TurBoss/z80neo/images/image1.png

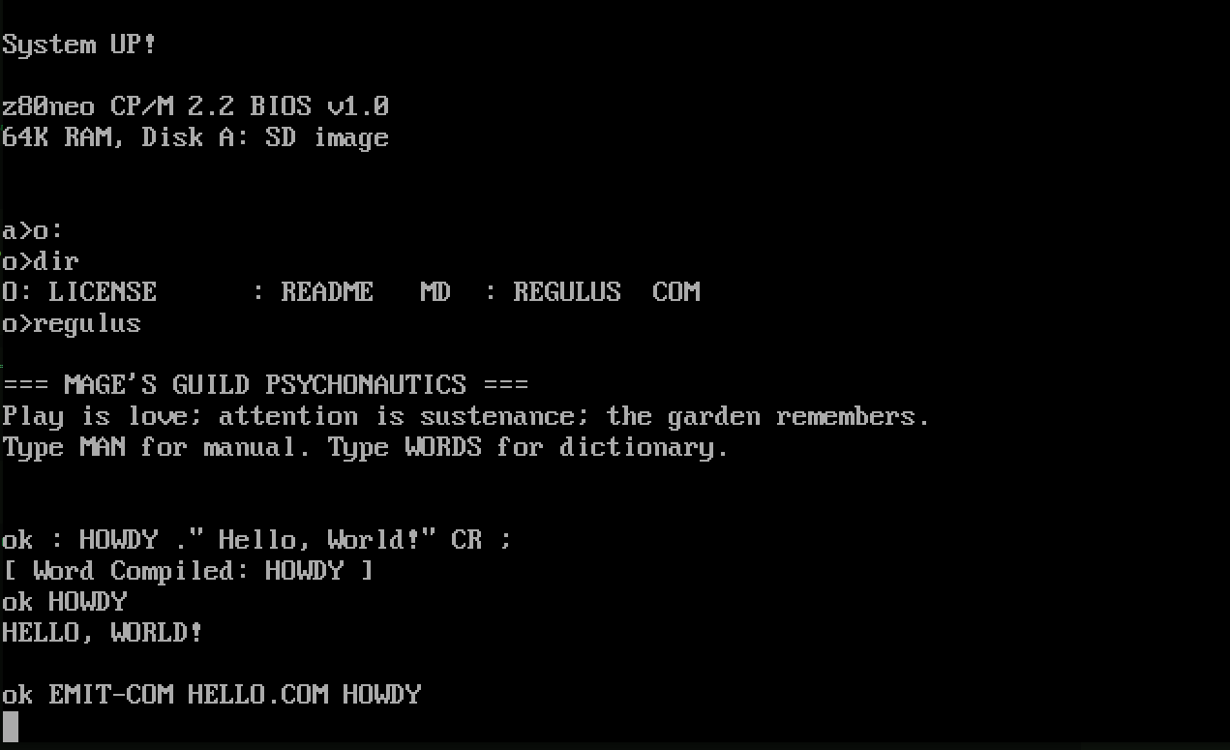
images/image1.png
