TurBoss/z80neo/images/image2.png

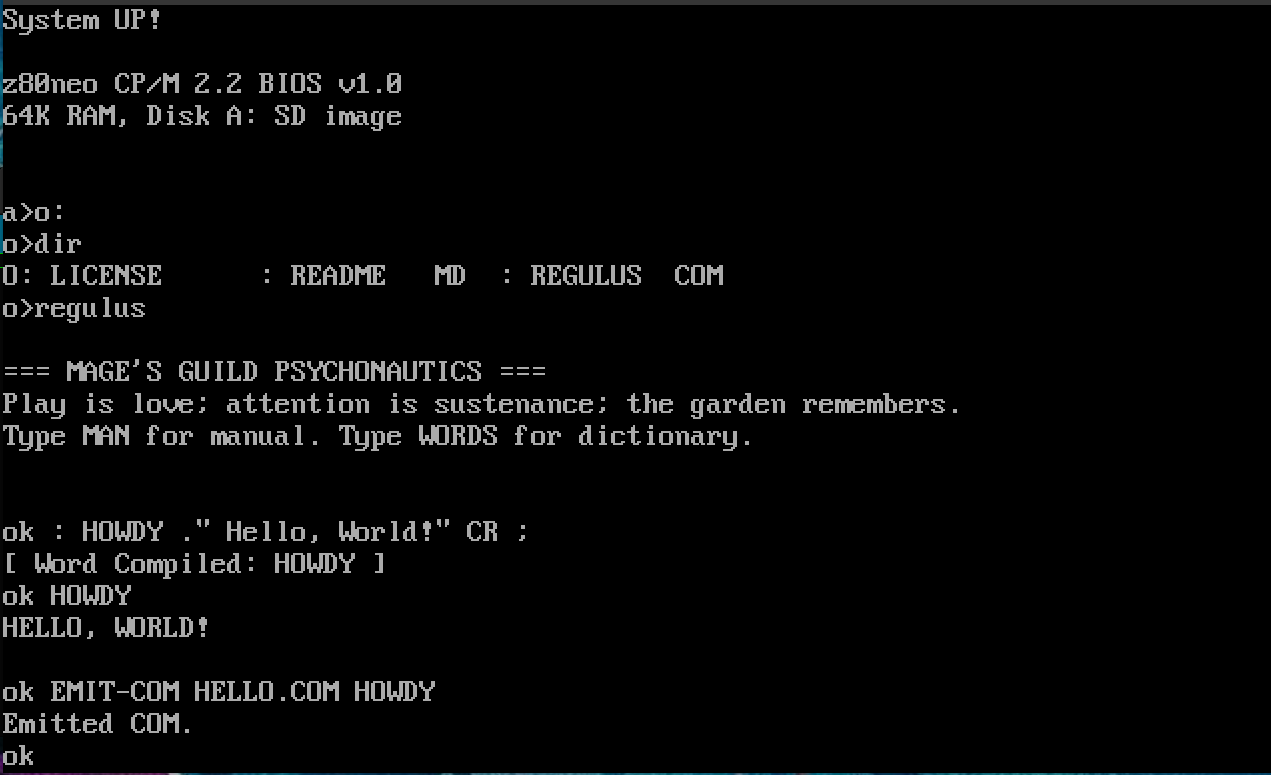
images/image2.png
