TurBoss/z80neo/images/image3.png

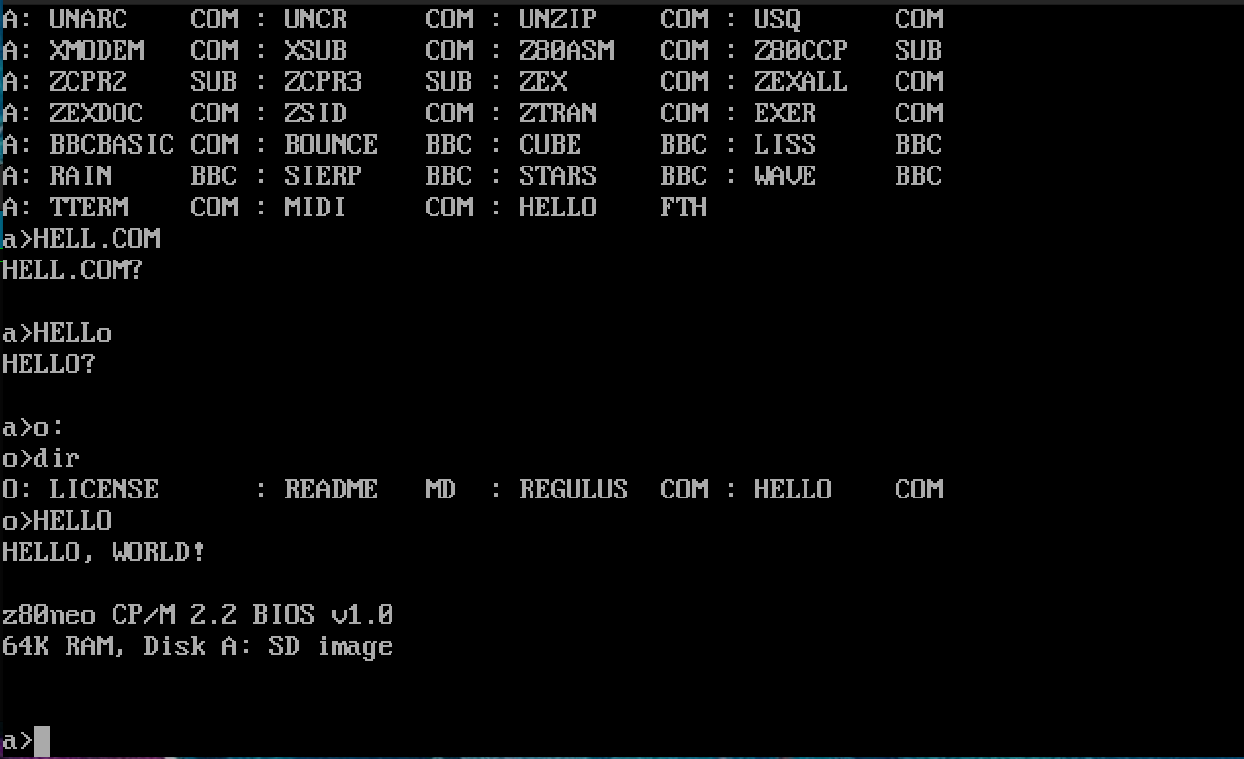
images/image3.png
