TurBoss/z80neo/images/image.png

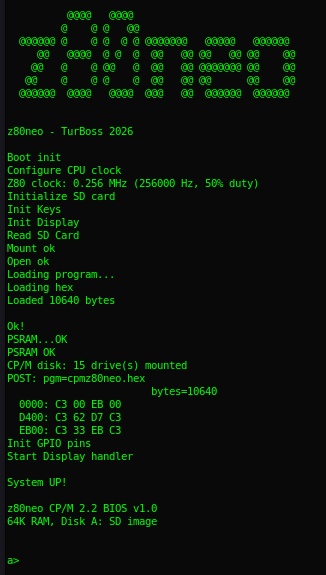
images/image.png
