TurBoss/z80neo/images/regulus.png

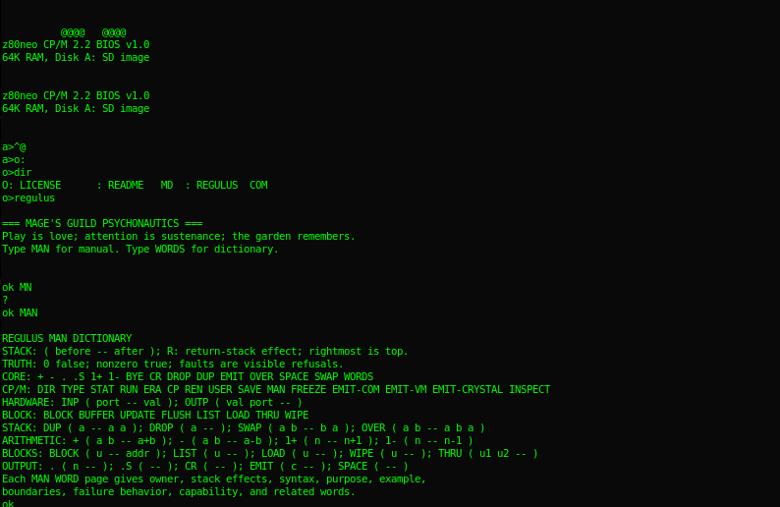
images/regulus.png
