TurBoss/z80neo/images/rn_image_picker_lib_temp_3ced0ee5-24de-4b00-89b0-9636c9db9d4b.jpg

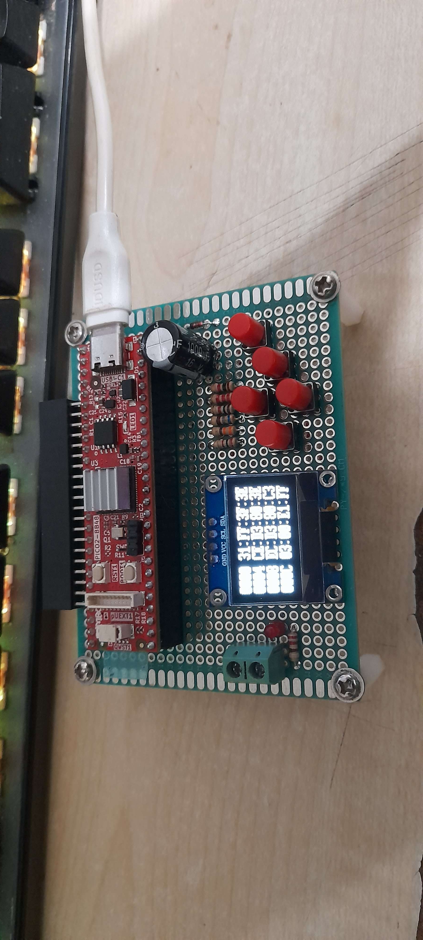
images/rn_image_picker_lib_temp_3ced0ee5-24de-4b00-89b0-9636c9db9d4b.jpg
