TurBoss/z80neo/images/rn_image_picker_lib_temp_8c398ad6-d32f-4aa8-9d74-71f9833cbe23.jpg

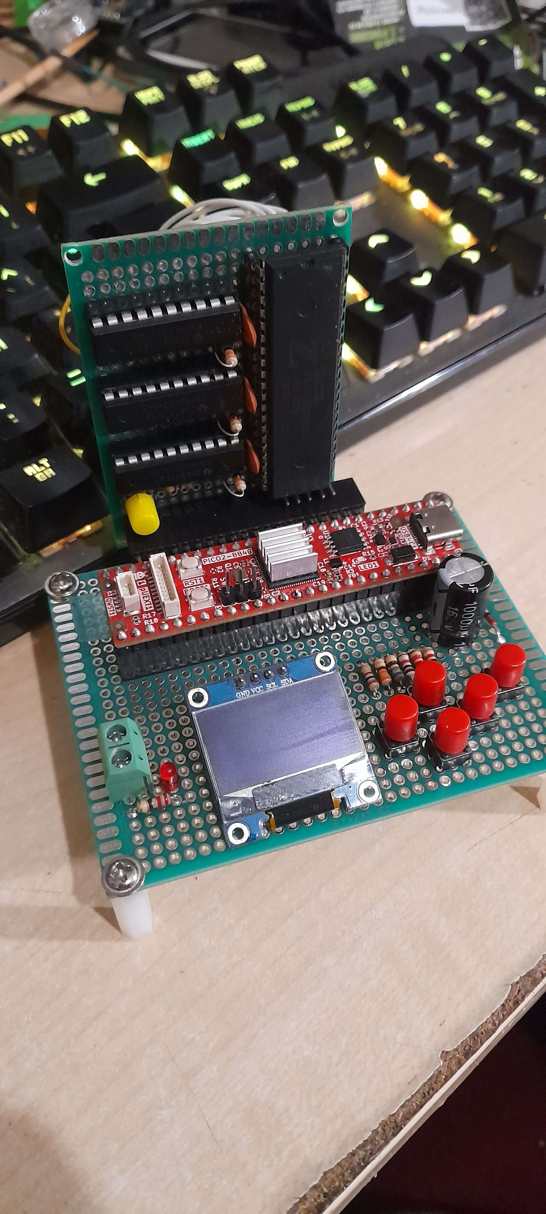
images/rn_image_picker_lib_temp_8c398ad6-d32f-4aa8-9d74-71f9833cbe23.jpg
