TurBoss/z80neo/images/rn_image_picker_lib_temp_10f30920-b8a1-4bfb-8cc0-7e3f8f440144.jpg

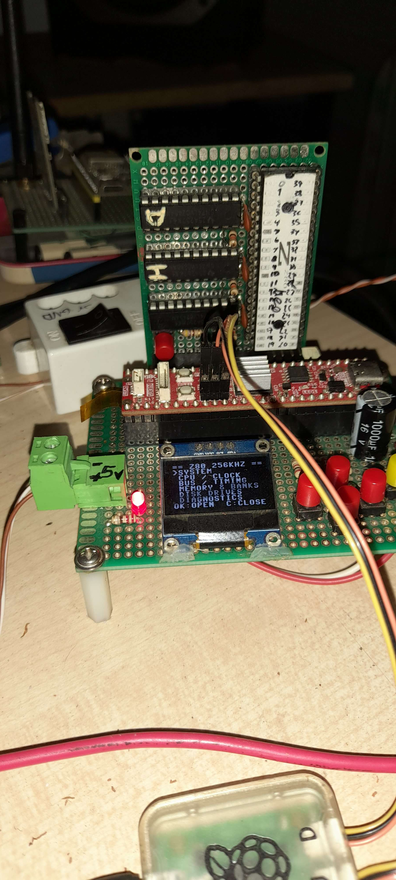
images/rn_image_picker_lib_temp_10f30920-b8a1-4bfb-8cc0-7e3f8f440144.jpg
