TurBoss/z80neo/images/rn_image_picker_lib_temp_57b4c988-b5c6-46c3-9d2c-d105b50022b2.jpg

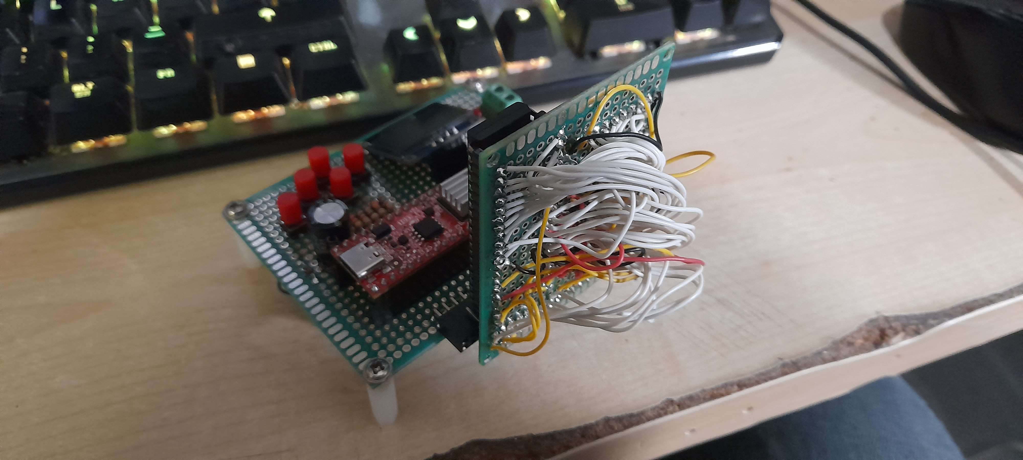
images/rn_image_picker_lib_temp_57b4c988-b5c6-46c3-9d2c-d105b50022b2.jpg
