TurBoss/z80neo/images/screen.png

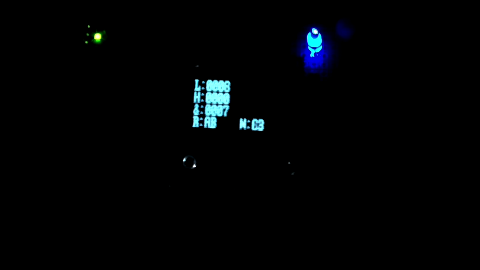
images/screen.png
