TurBoss/z80neo/images/z80neo_THT.png

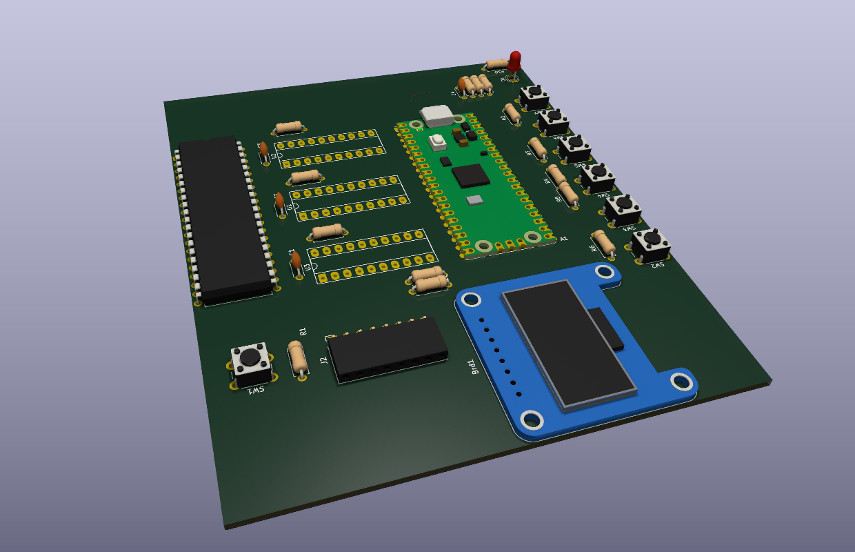
images/z80neo_THT.png
