TurBoss/z80neo/images/z80neo_v2.jpg

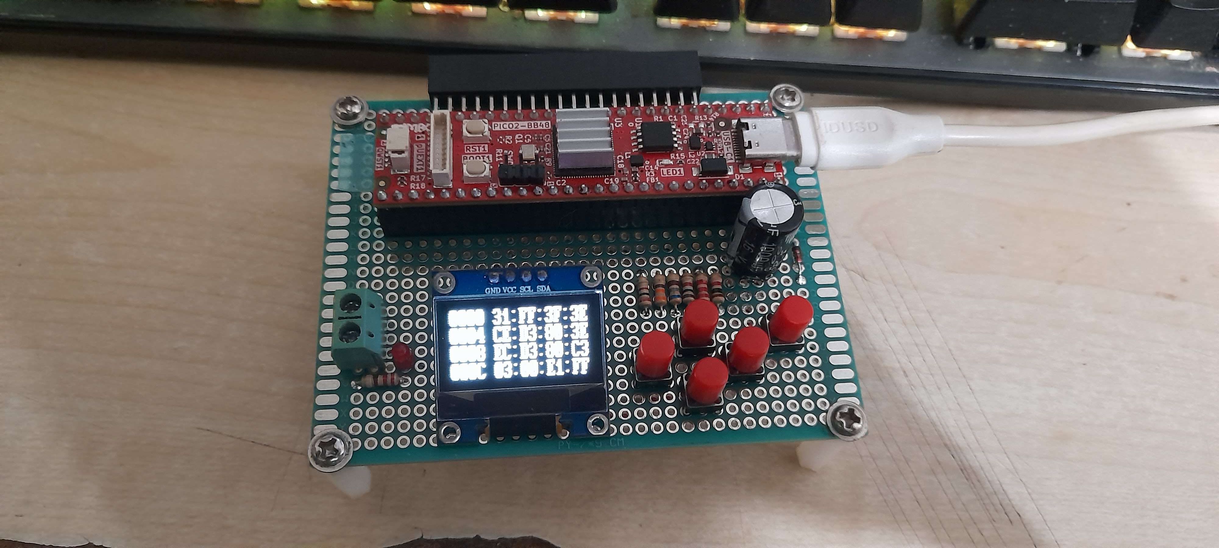
images/z80neo_v2.jpg
