TurBoss/z80neo/doc/RP2350-PICO2-BB48-user-manual-1.pdf

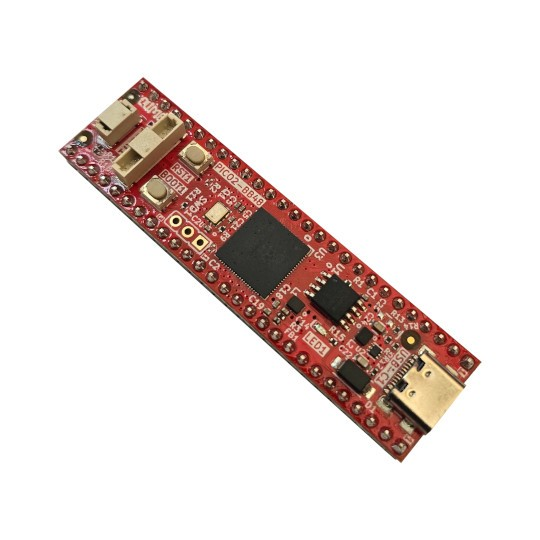
[picture p20: figure]

# RP2350-PICO2-BB48

# User Manual

Rev.1.0 September 2025 | olimex.com

Table of Contents

### Introduction to RP2350-PICO2-BB48

RP2350-PICO2- (https://www.olimex.com/Products/RaspberryPi/PICO/RP2350-PICO2-BB48/open-source-hardware) BB48 (https://www.olimex.com/Products/RaspberryPi/PICO/RP2350-PICO2-BB48/open-source-hardware) is re-design of the popular Raspberry PI PICO2 board with these improvements:

- all 48 RP2350 GPIOs are available to the user
- USB-C power supply connector which allow more current to be used by the board
- DCDC power supply voltage regulator 3.3V 2A (3A peak)
- 16MB Flash versions
- 8MB PSRAM for BB48R version
- micro SD card connector for XXL version
- RESET button is add
- Four layer board for better noise immunity and USB differential pair routing
- UEXT connector (pUEXT 1.0 mm step connector)
- Qwiic/Stemma connector
- Distance between signal rows 0.6” (15.24mm)
- Dimensions 69x18 mm

# Note:

Both RP2350-PICO2- (https://www.olimex.com/Products/RaspberryPi/PICO/RP2350-PICO2-BB48/open-source-hardware) BB48 (https://www.olimex.com/Products/RaspberryPi/PICO/RP2350-PICO2-BB48/open-source-hardware) and RP2350-PICO2- (https://www.olimex.com/Products/RaspberryPi/PICO/RP2350-PICO2-BB48/open-source-hardware) BB48R (https://www.olimex.com/Products/RaspberryPi/PICO/RP2350-PICO2-BB48/open-source-hardware) share same PCB with same silkscreen where PP2350-PICO2-BB48 is written! The only difference is that in BB48 version PSRAM and micro SD card (both on bottom side of the PCB) are not populated.

### Order codes for RP2350-PICO2-BB48 and accessories:

RP2350-PICO2- (https://www.olimex.com/Products/RaspberryPi/PICO/RP2350-PICO2-BB48/open-source-hardware) BB48 (https://www.olimex.com/Products/RaspberryPi/PICO/RP2350-PICO2-BB48/open-source-hardware) | industrial grade RP2350-PICO2 board with 48 GPIOs exposed
RP2350-PICO2- (https://www.olimex.com/Products/RaspberryPi/PICO/RP2350-PICO2-BB48R/open-source-hardware) BB48R (https://www.olimex.com/Products/RaspberryPi/PICO/RP2350-PICO2-BB48R/open-source-hardware) | includes everything in BB48 plus 8MB PSRAM and microSD card

USB-CABLE-AM-USB3-C (https://www.olimex.com/Products/Components/Cables/USB-CABLE-AM-USB3-C/) high quality USB-C cable for power and programming

p (https://www.olimex.com/Products/Modules/Adapters/pUEXT-CABLE-10-10-200MM/) UEXT (https://www.olimex.com/Products/Modules/Adapters/pUEXT-CABLE-10-10-200MM/) pack of (https://www.olimex.com/Products/Modules/Adapters/pUEXT-CABLE-10-10-200MM/) cable (https://www.olimex.com/Products/Modules/Adapters/pUEXT-CABLE-10-10-200MM/) s (https://www.olimex.com/Products/Modules/Adapters/pUEXT-CABLE-10-10-200MM/) | pack of 3 pcs 200 mm pUEXT cables
UEXT-MPQ (https://www.olimex.com/Products/Modules/Adapters/UEXT-MPQ/open-source-hardware) | converter board from pUEXT to UEXT

### HARDWARE

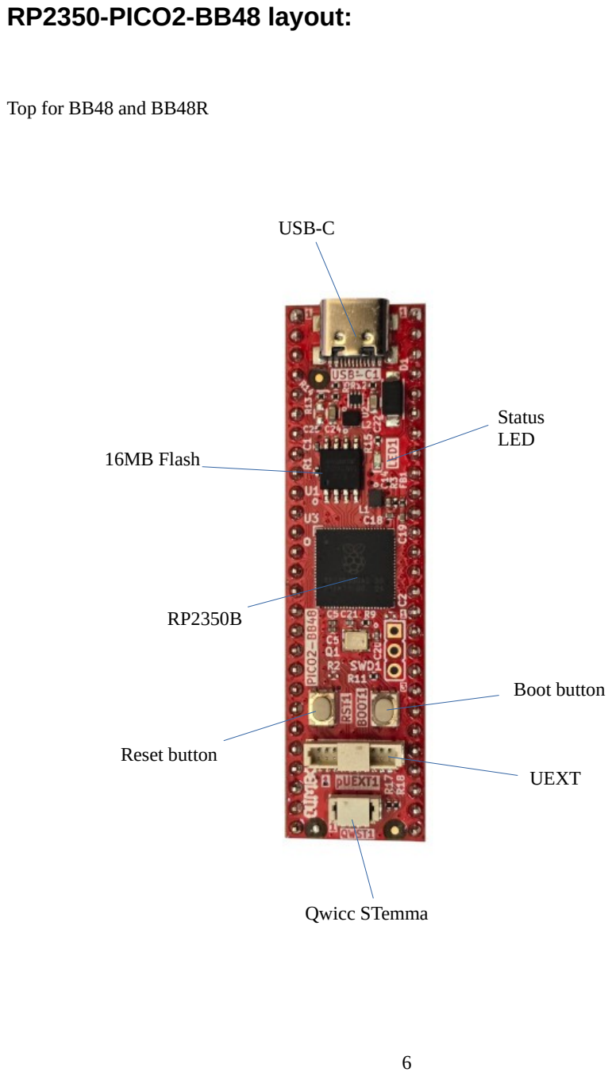
[picture p21: page 6]

RP2350-PICO2-BB48 layout:

Top for BB48 and BB48R

USB-C

Status
LED

Boot button

UEXT

Qwicc STemma

Reset button

RP2350B

16MB Flash

Bottom for BB48

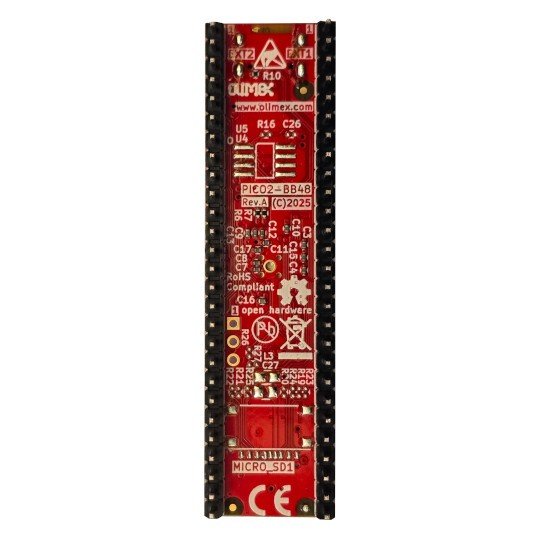
[picture p22: figure]
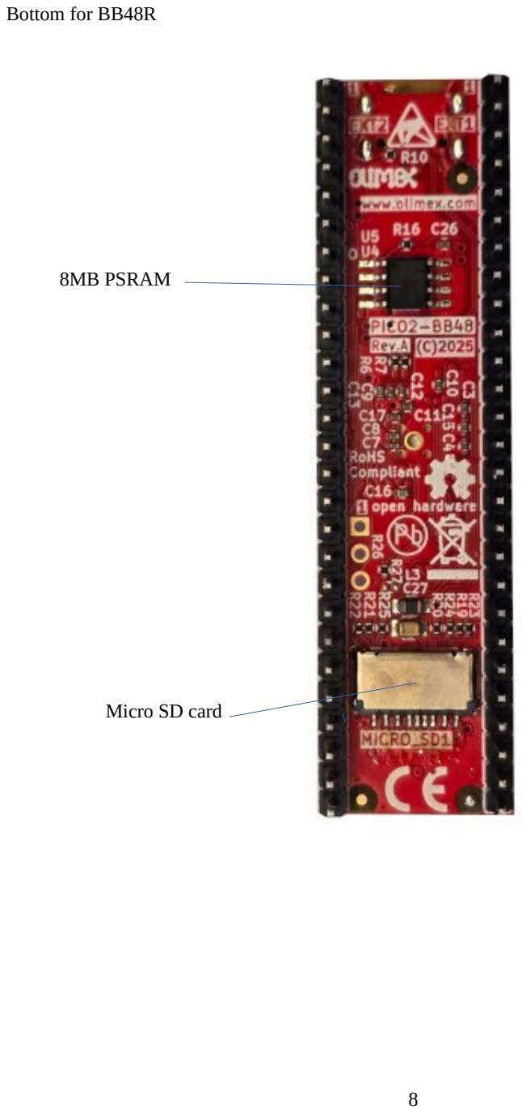
[picture p23: page 8]

Bottom for BB48R

8MB PSRAM

Micro SD card

RP2350-PICO2-BB48 GPIOs:

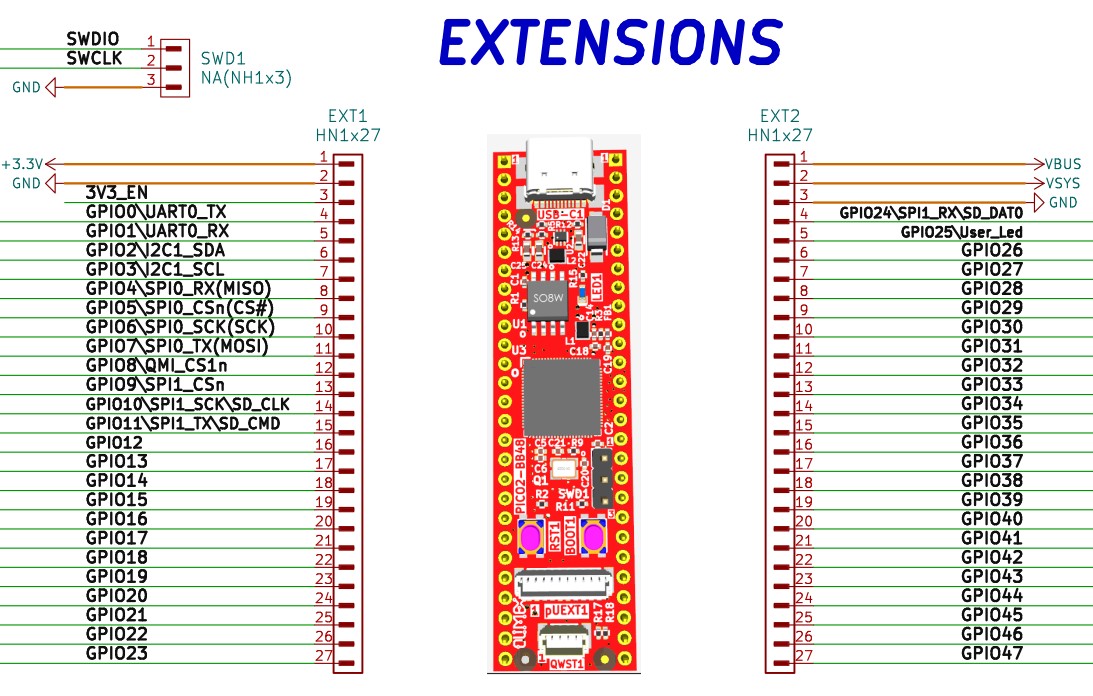
[picture p24: figure]

## POWER SUPPLY:

VBUS | +5V from, USB-C output
VDD_SYS | +5V may be output or input
| if you want to use as input i.e. to feed power from external 5V to this line make sure board is not connected to USB!
| when you use as output i.e. you feed external electronics from it up to 1A @ 5V
+3.3V | output which can source up to 2A @ 3.3V
3V3_EN | input, when pulled to GND stops the 3.3V DCDC convertor

RP2350-PICO2-BB48 schematics:

RP2350-PICO2- (https://www.olimex.com/Products/RaspberryPi/PICO/RP2350-PICO2-BB48/open-source-hardware) BB48 (https://www.olimex.com/Products/RaspberryPi/PICO/RP2350-PICO2-BB48/open-source-hardware) latest schematic is on GitHub. (https://github.com/OLIMEX/RP2350-PICO2-BB48/tree/main/HARDWARE)

UEXT connector:

UEXT connector stands for Universal EXTension connector and contain +3.3V, GND, I2C, SPI, UART signals.

UEXT connector can be in different shapes.

The original UEXT connector is 0.1” 2.54mm step boxed plastic connector. All signals are with 3.3V levels.

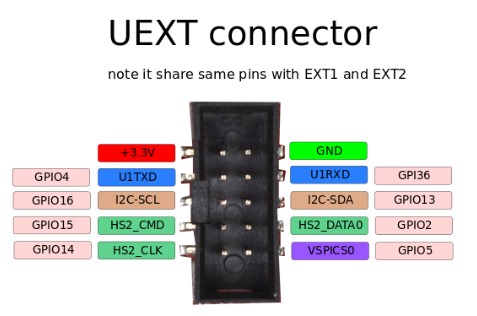
[picture p25: figure]

As the boards become smaller and smaller some smaller packages were introduced too beside the original UEXT connector

- mUEXT is 1.27 mm step boxed header connector which is with same layout as UEXT
- pUEXT is 1.0 mm single row connector (this is the connector used in RP2040-PICO30)

Olimex has developed number of MODULES (https://www.olimex.com/Products/Modules/) with this connector. There are temperature, humidity, pressure, magnetic field, light sensors. Modules with LCDs, LED matrix, Relays, Bluetooth, Zigbee, WiFi, GSM, GPS, RFID, RTC, EKG, sensors and etc.

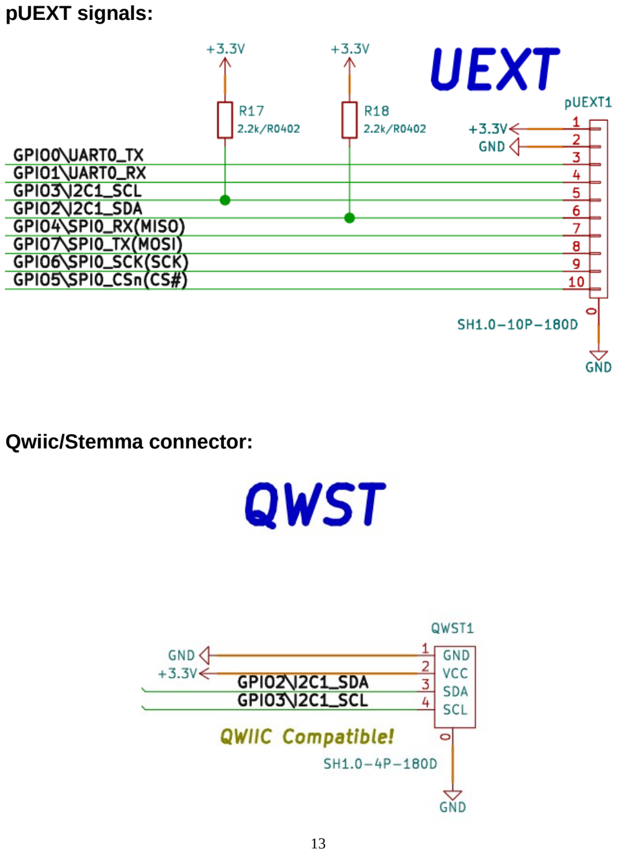
[picture p26: page 13]

pUEXT signals:

Qwiic/Stemma connector:

Micro SD card connection:

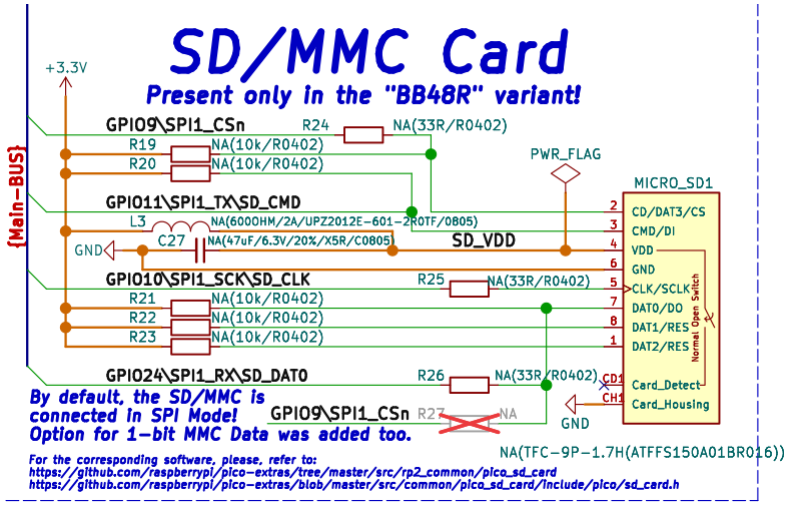
[picture p27: figure]

PSRAM connection:

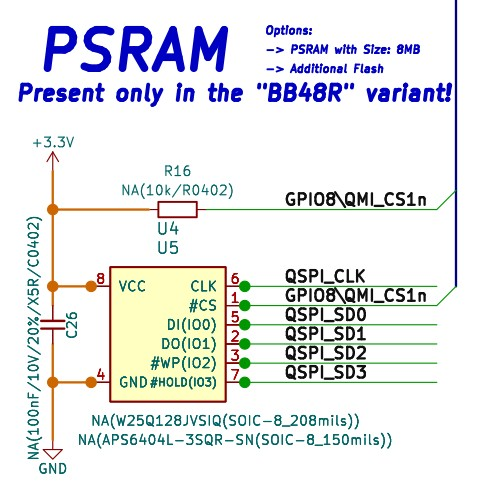
[picture p28: figure]

LED connection:

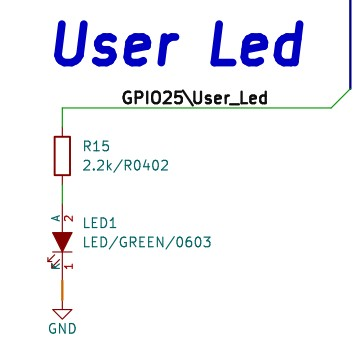
[picture p29: figure]

### SOFTWARE:

RP2350-PICO2-BB48 uses same software as PICO2

- Raspberry PI C-SDK
- MicroPython SDK (note that to the current date RP2350B chip support is not implemented in MicroPython and the access of the GPIO30-47 in MicroPython is not implemented.
- CircuitPython from Adafruit – all 48 GPIOs are implemented.

### Revision History

Revision 1.0 September 2025
