TurBoss/z80neo/hardware/z80neo_03.pdf

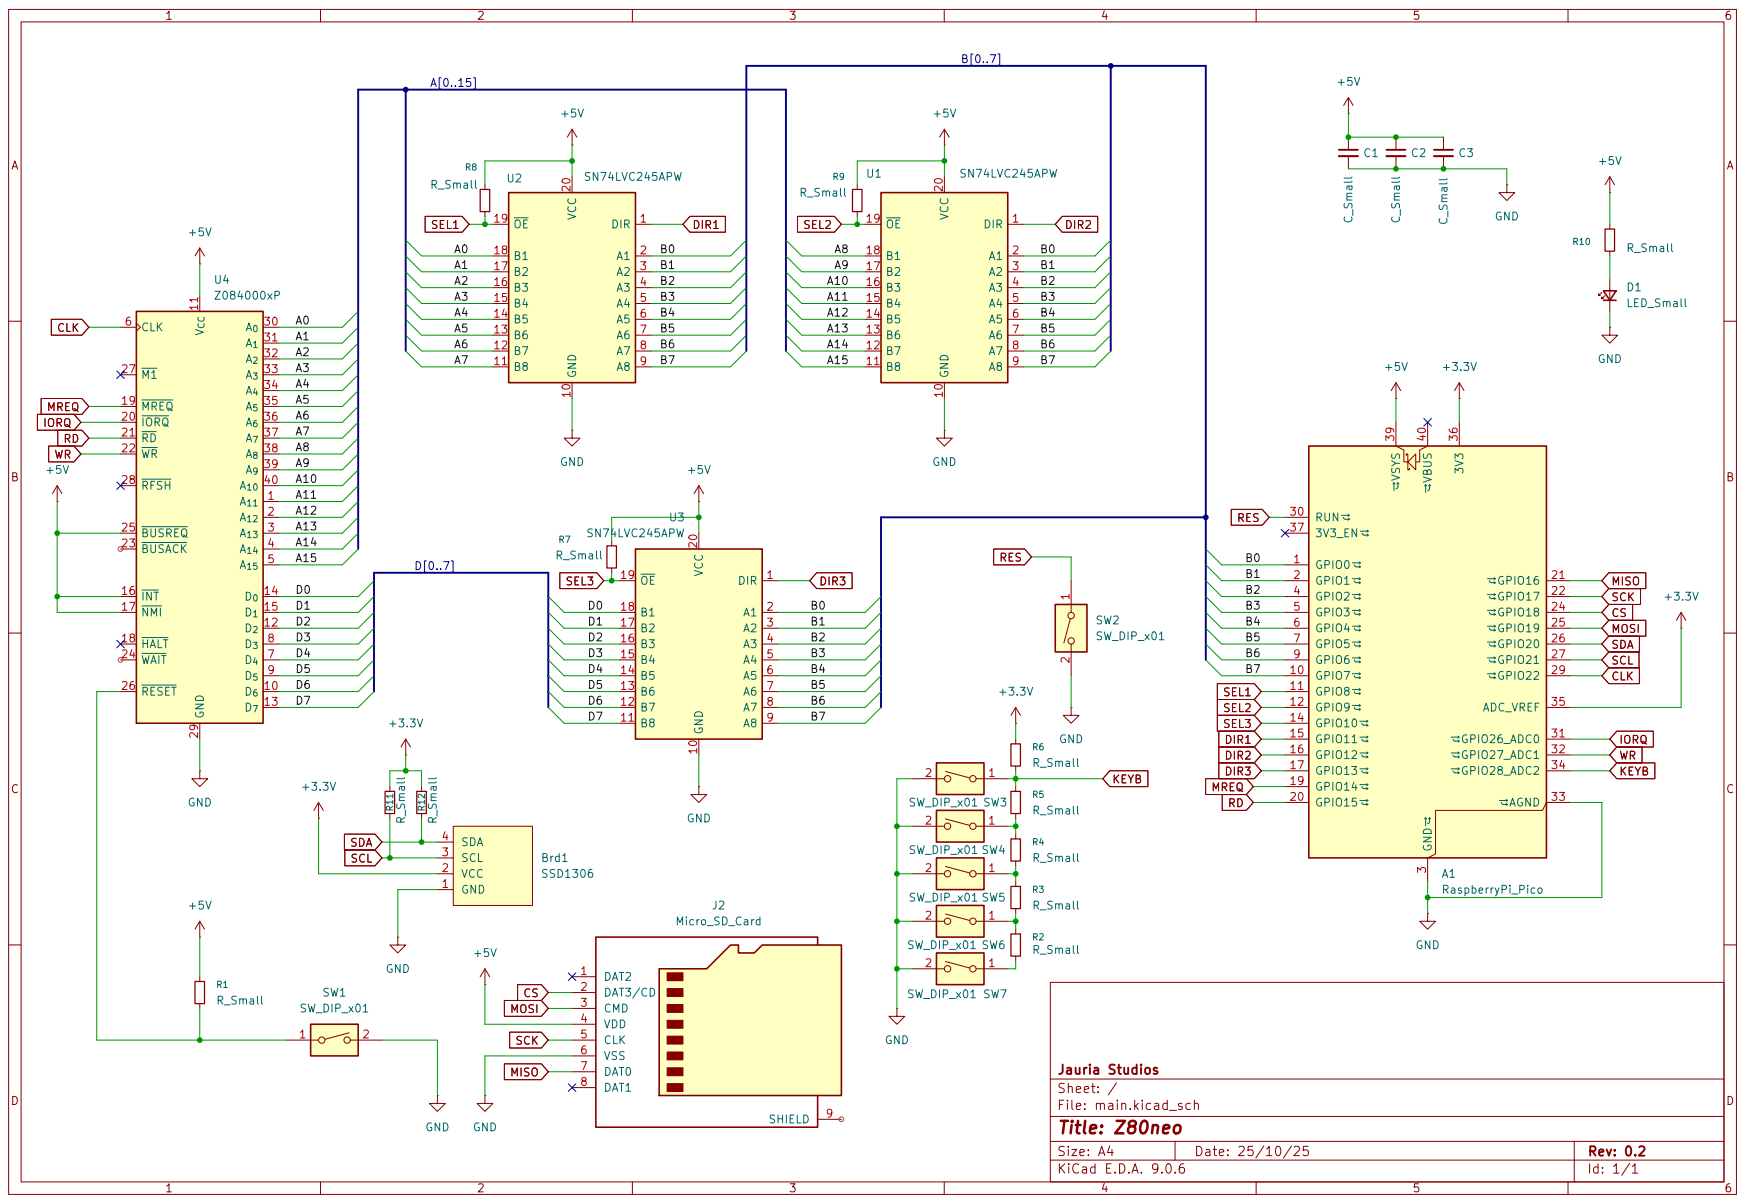
[picture p31: page 1]
