TurBoss/z80neo/hardware/z80neo_02.pdf

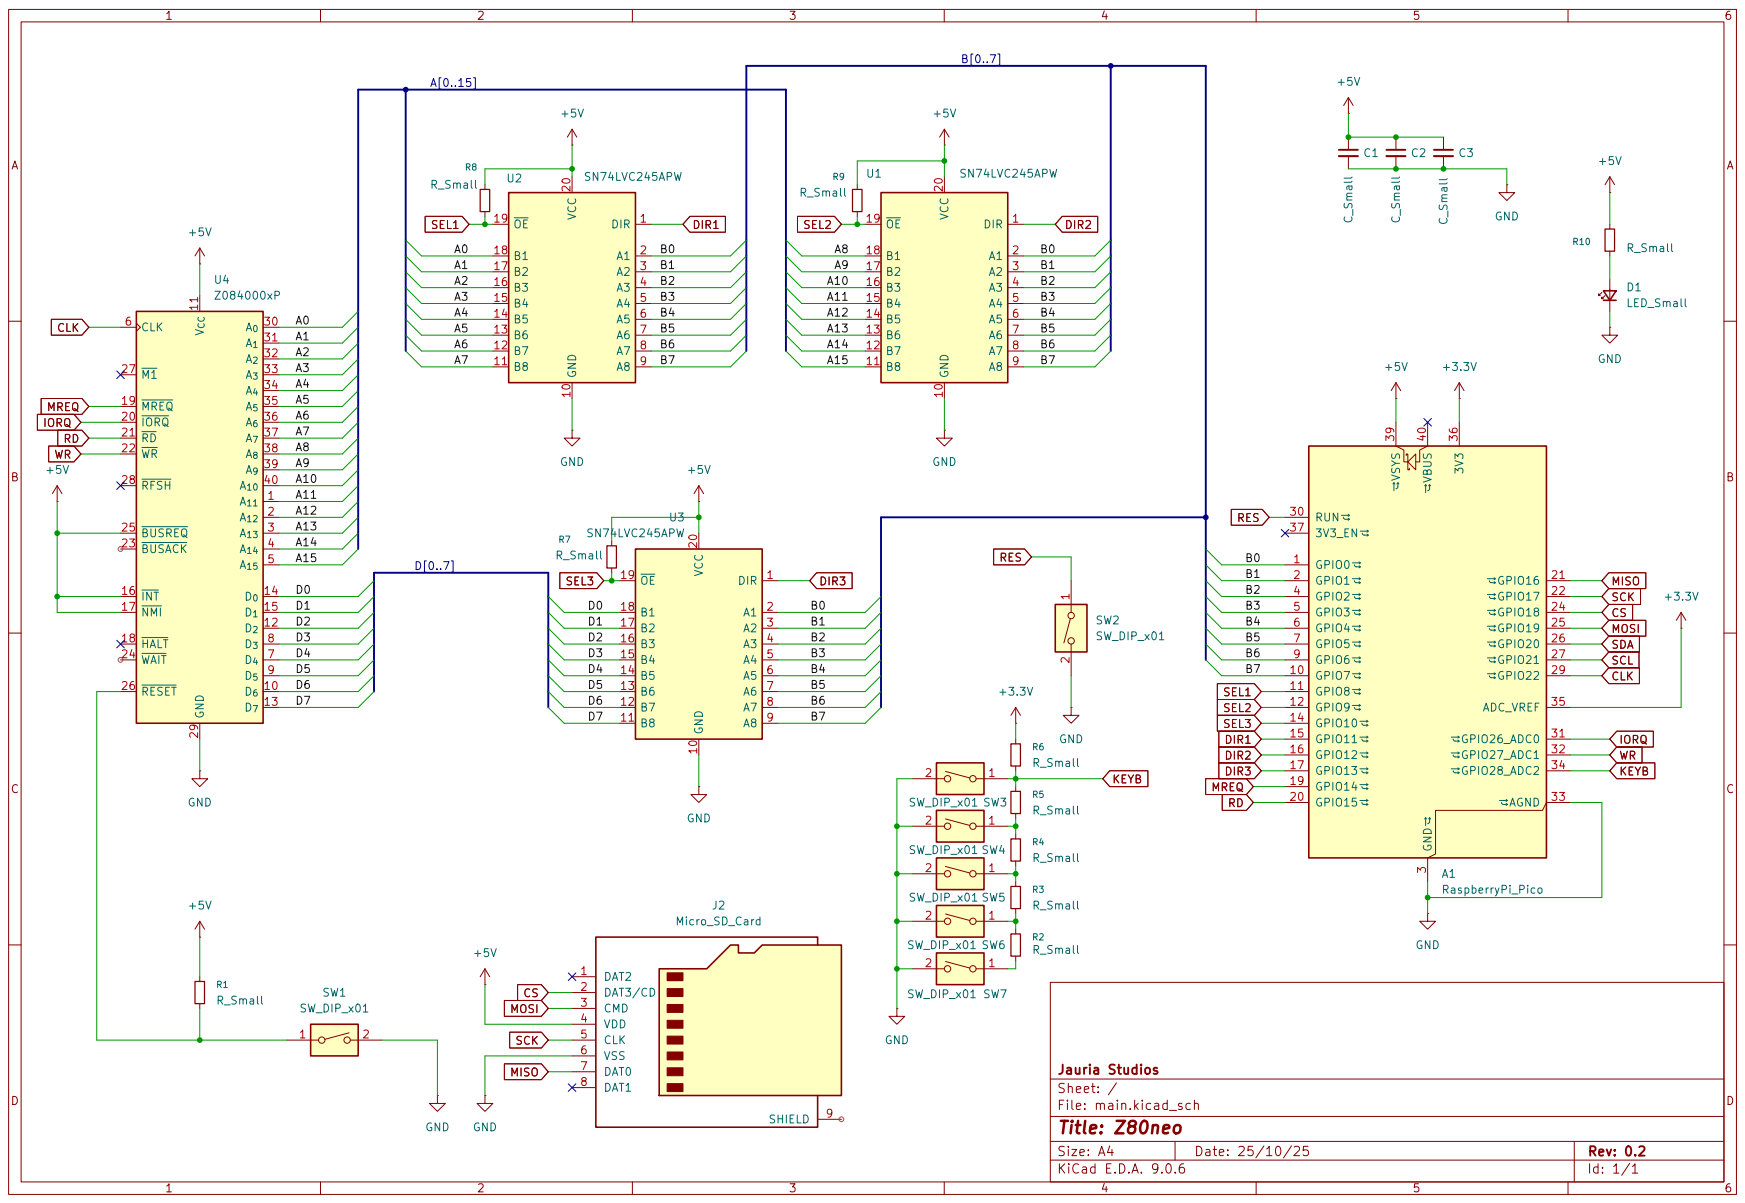
[picture p32: page 1]
