TurBoss/z80neo/hardware/z80neo_01.pdf

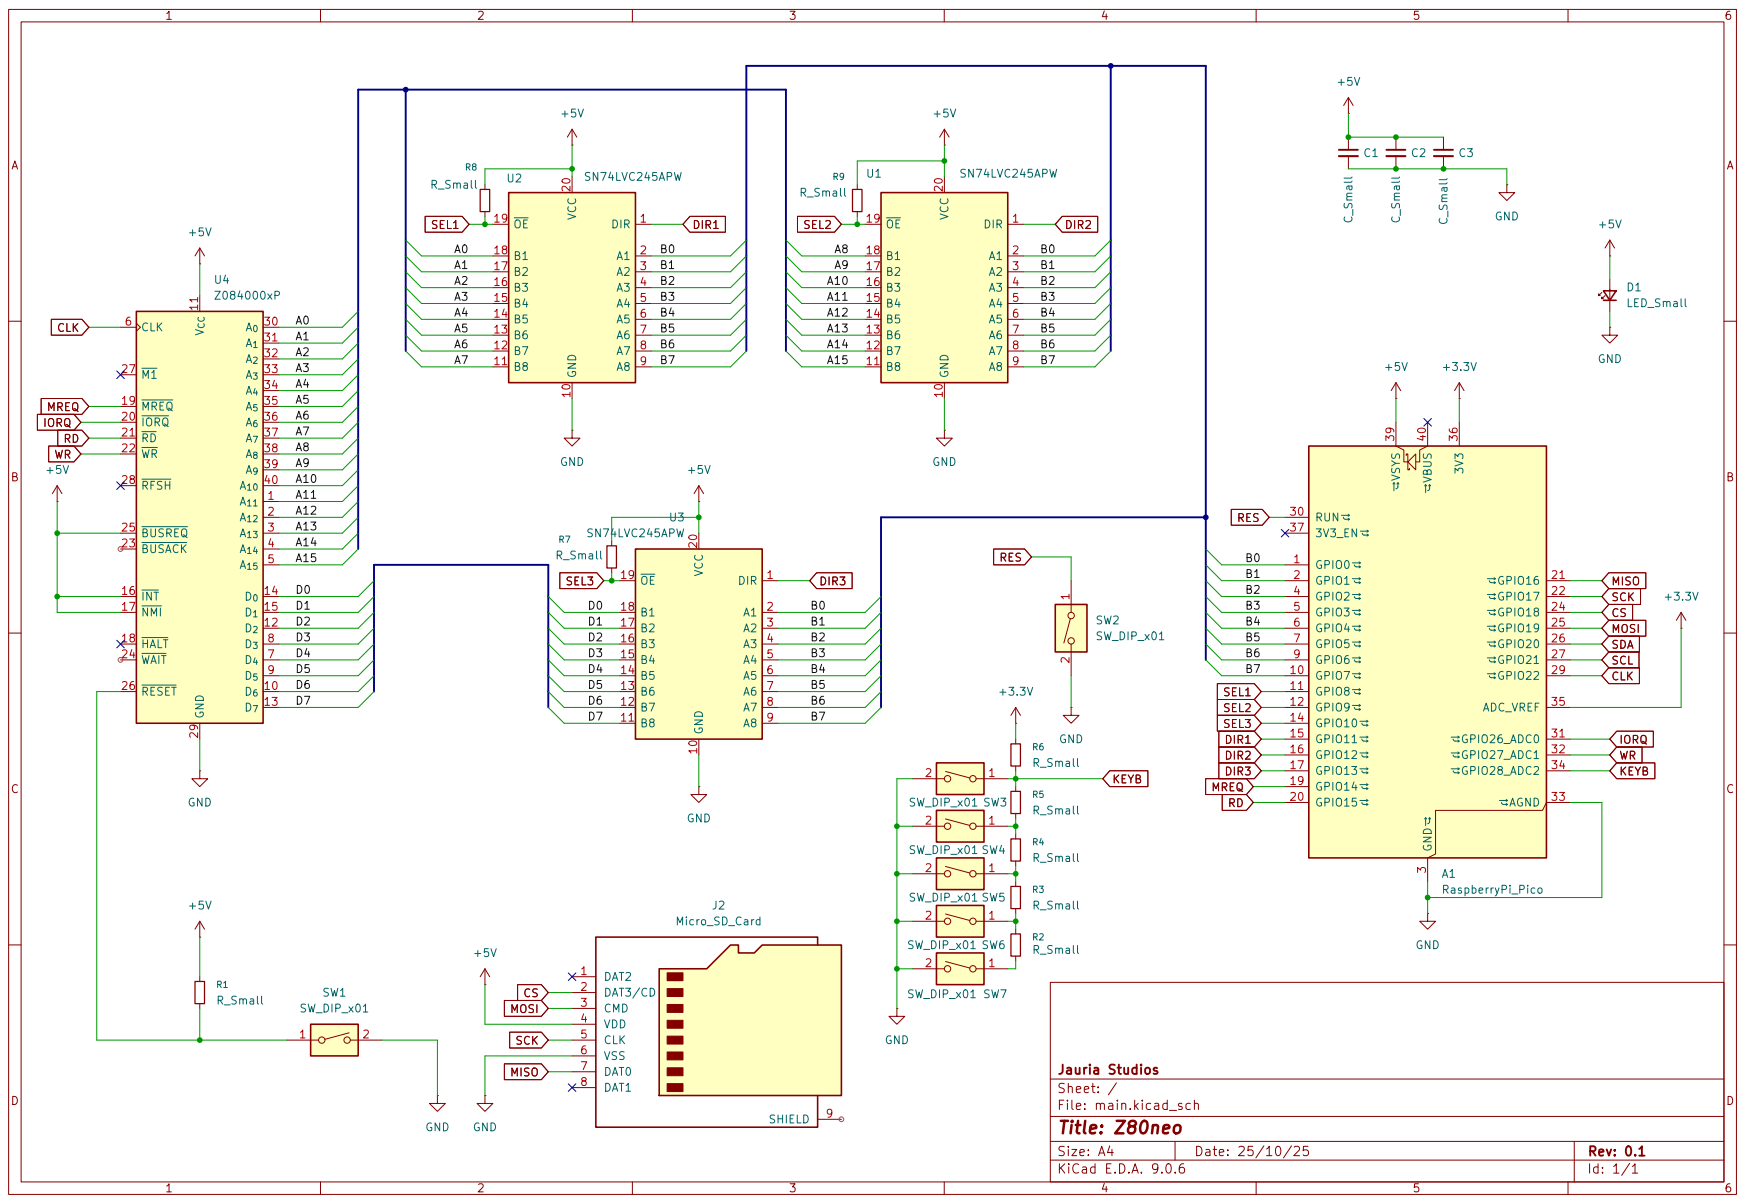
[picture p33: page 1]
