TurBoss/z80neo/hardware/main.kicad_pcb

## KiCad design hardware/main.kicad_pcb (2025-11-22)

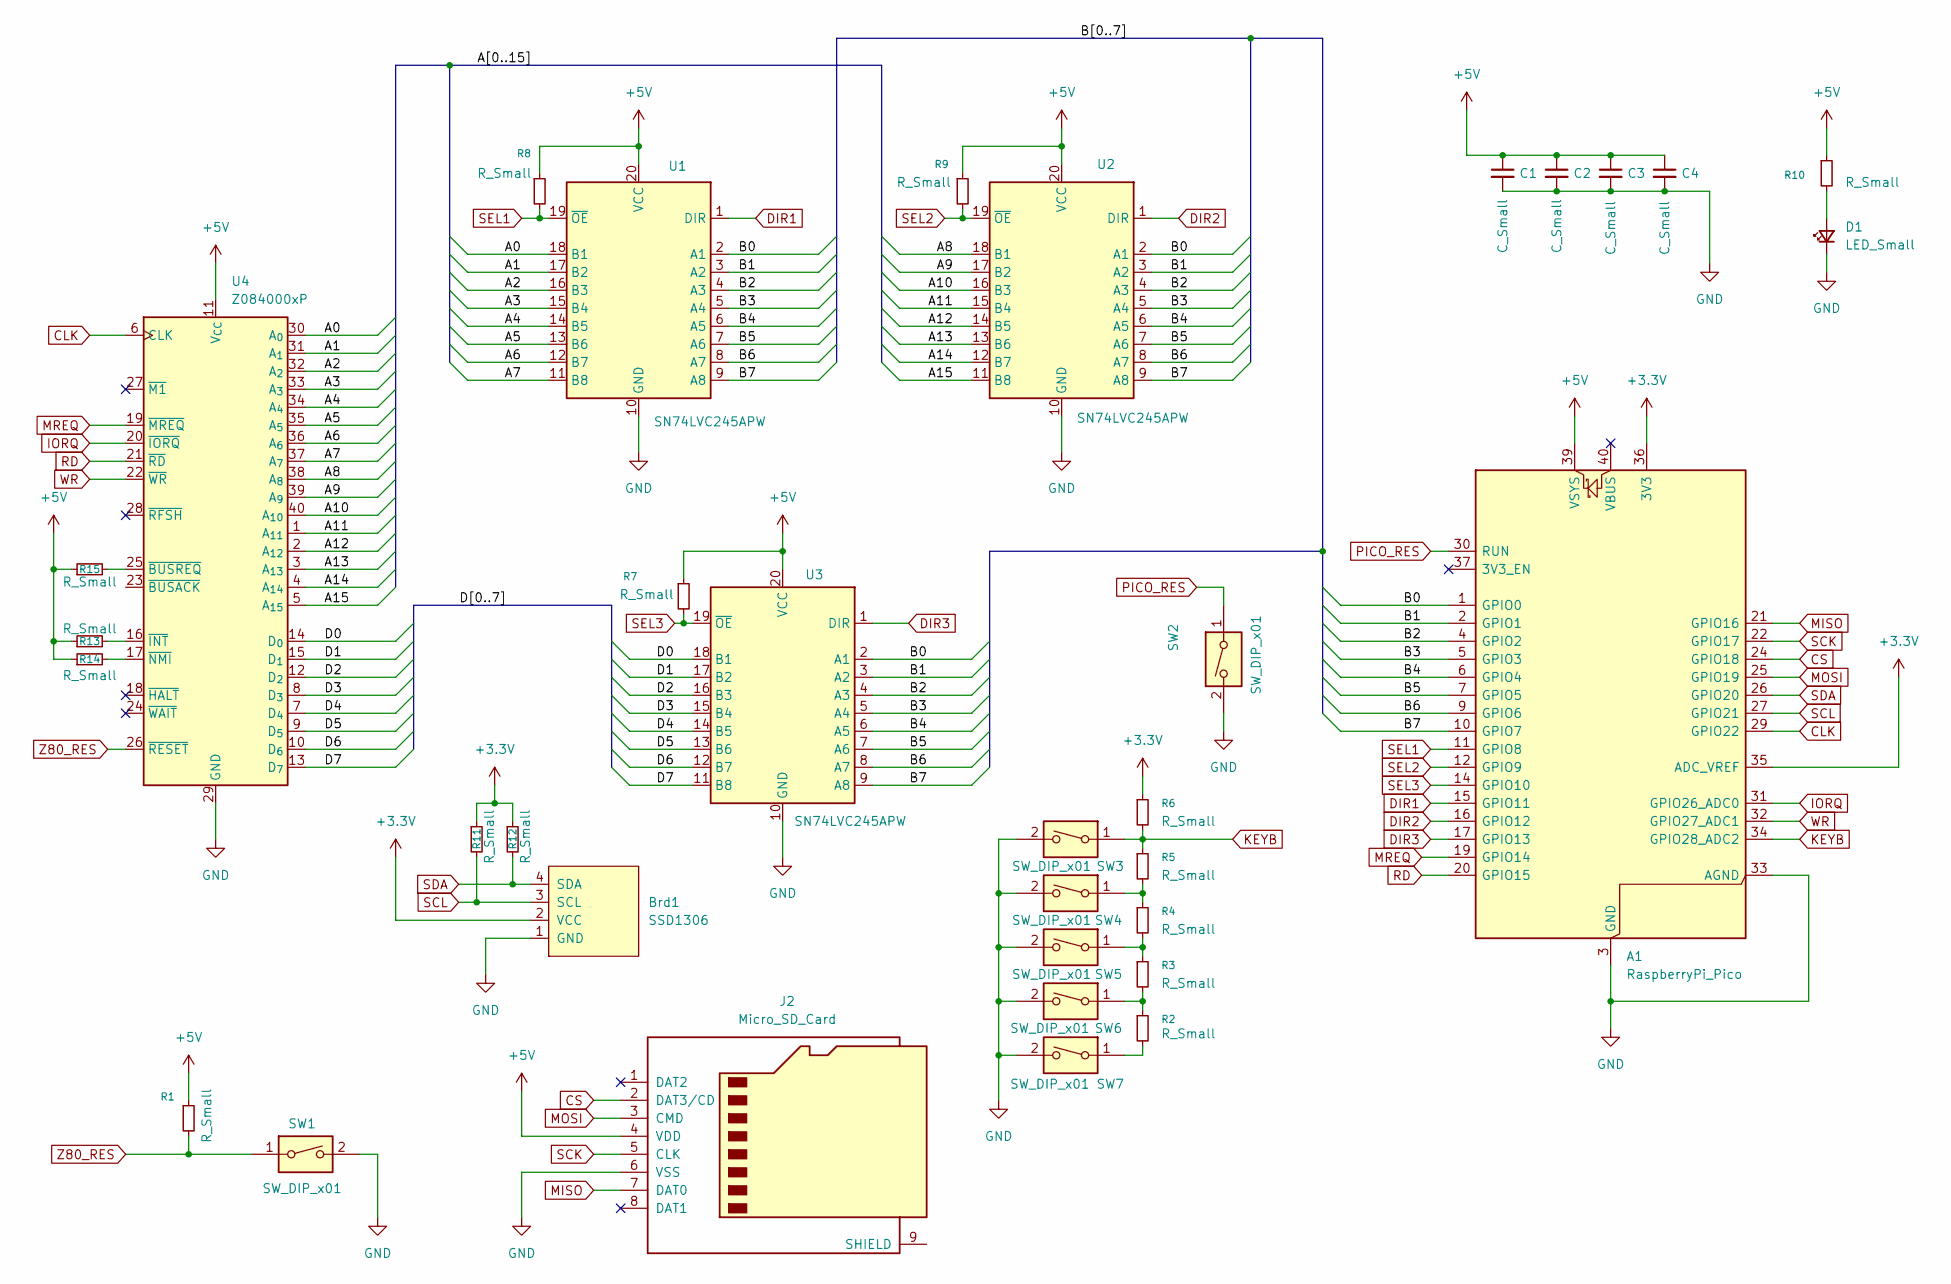
[picture p34: schematic main.kicad_sch, Z80neo]

Parts:
A1: RaspberryPi_Pico; RaspberryPi_Pico_Common_Unspecified
Brd1: SSD1306; Adafruit_SSD1306_No_Mounting_Holes
C1, C2, C3, C4: C_Small; C_Disc_D4.3mm_W1.9mm_P5.00mm
D1: LED_Small; LED_D3.0mm
J2: Micro_SD_Card; PinSocket_1x08_P2.54mm_Horizontal
R1, R2, R3, R4, R5, R6, R7, R8, R9, R10, R11, R12, R13, R14, R15: R_Small; R_Axial_DIN0207_L6.3mm_D2.5mm_P7.62mm_Horizontal
SW1, SW2, SW3, SW4, SW5, SW6, SW7: SW_DIP_x01; SW_PUSH_6mm
U1, U2, U3: SN74LVC245APW; CERDIP-20_W7.62mm_SideBrazed_LongPads_Socket
U4: Z084000xP; DIP-40_W15.24mm

Connections:
+3.3V: A1.35 (ADC_VREF), A1.36 (3V3), Brd1.2 (VCC), R6.1, R11.1, R12.1
+5V: A1.39 (VSYS), C1.1, C2.1, C3.1, C4.1, J2.4 (VDD), R1.1, R7.1, R8.1, R9.1, R10.1, R13.1, R14.1, R15.1, U1.20 (VCC), U2.20 (VCC), U3.20 (VCC), U4.11 (V_{CC})
/A0: U1.18 (B1), U4.30 (A_{0})
/A1: U1.17 (B2), U4.31 (A_{1})
/A2: U1.16 (B3), U4.32 (A_{2})
/A3: U1.15 (B4), U4.33 (A_{3})
/A4: U1.14 (B5), U4.34 (A_{4})
/A5: U1.13 (B6), U4.35 (A_{5})
/A6: U1.12 (B7), U4.36 (A_{6})
/A7: U1.11 (B8), U4.37 (A_{7})
/A8: U2.18 (B1), U4.38 (A_{8})
/A9: U2.17 (B2), U4.39 (A_{9})
/A10: U2.16 (B3), U4.40 (A_{10})
/A11: U2.15 (B4), U4.1 (A_{11})
/A12: U2.14 (B5), U4.2 (A_{12})
/A13: U2.13 (B6), U4.3 (A_{13})
/A14: U2.12 (B7), U4.4 (A_{14})
/A15: U2.11 (B8), U4.5 (A_{15})
/B0: A1.1 (GPIO0), U1.2 (A1), U2.2 (A1), U3.2 (A1)
/B1: A1.2 (GPIO1), U1.3 (A2), U2.3 (A2), U3.3 (A2)
/B2: A1.4 (GPIO2), U1.4 (A3), U2.4 (A3), U3.4 (A3)
/B3: A1.5 (GPIO3), U1.5 (A4), U2.5 (A4), U3.5 (A4)
/B4: A1.6 (GPIO4), U1.6 (A5), U2.6 (A5), U3.6 (A5)
/B5: A1.7 (GPIO5), U1.7 (A6), U2.7 (A6), U3.7 (A6)
/B6: A1.9 (GPIO6), U1.8 (A7), U2.8 (A7), U3.8 (A7)
/B7: A1.10 (GPIO7), U1.9 (A8), U2.9 (A8), U3.9 (A8)
/D0: U3.18 (B1), U4.14 (D_{0})
/D1: U3.17 (B2), U4.15 (D_{1})
/D2: U3.16 (B3), U4.12 (D_{2})
/D3: U3.15 (B4), U4.8 (D_{3})
/D4: U3.14 (B5), U4.7 (D_{4})
/D5: U3.13 (B6), U4.9 (D_{5})
/D6: U3.12 (B7), U4.10 (D_{6})
/D7: U3.11 (B8), U4.13 (D_{7})
CLK: A1.29 (GPIO22), U4.6 (CLK)
CS: A1.24 (GPIO18), J2.2 (DAT3/CD)
DIR1: A1.15 (GPIO11), U1.1 (DIR)
DIR2: A1.16 (GPIO12), U2.1 (DIR)
DIR3: A1.17 (GPIO13), U3.1 (DIR)
GND: A1.3 (GND), A1.8 (GND), A1.13 (GND), A1.18 (GND), A1.23 (GND), A1.28 (GND), A1.33 (AGND), A1.38 (GND), Brd1.1 (GND), C1.2, C2.2, C3.2, C4.2, D1.1 (K), J2.6 (VSS), SW1.2, SW2.2, SW3.2, SW4.2, SW5.2, SW6.2, SW7.2, U1.10 (GND), U2.10 (GND), U3.10 (GND), U4.29 (GND)
IORQ: A1.31 (GPIO26_ADC0), U4.20 (~IORQ)
KEYB: A1.34 (GPIO28_ADC2), R5.1, R6.2, SW3.1
MISO: A1.21 (GPIO16), J2.7 (DAT0)
MOSI: A1.25 (GPIO19), J2.3 (CMD)
MREQ: A1.19 (GPIO14), U4.19 (~MREQ)
unnamed: D1.2 (A), R10.2
unnamed: R2.1, R3.2, SW6.1
unnamed: R2.2, SW7.1
unnamed: R3.1, R4.2, SW5.1
unnamed: R4.1, R5.2, SW4.1
unnamed: R15.2, U4.25 (~BUSREQ)
unnamed: R13.2, U4.16 (~INT)
unnamed: R14.2, U4.17 (~NMI)
PICO_RES: A1.30 (RUN), SW2.1
RD: A1.20 (GPIO15), U4.21 (~RD)
SCK: A1.22 (GPIO17), J2.5 (CLK)
SCL: A1.27 (GPIO21), Brd1.3 (SCL), R11.2
SDA: A1.26 (GPIO20), Brd1.4 (SDA), R12.2
SEL1: A1.11 (GPIO8), R8.2, U1.19 (~OE)
SEL2: A1.12 (GPIO9), R9.2, U2.19 (~OE)
SEL3: A1.14 (GPIO10), R7.2, U3.19 (~OE)
WR: A1.32 (GPIO27_ADC1), U4.22 (~WR)
Z80_RES: R1.2, SW1.1, U4.26 (~RESET)

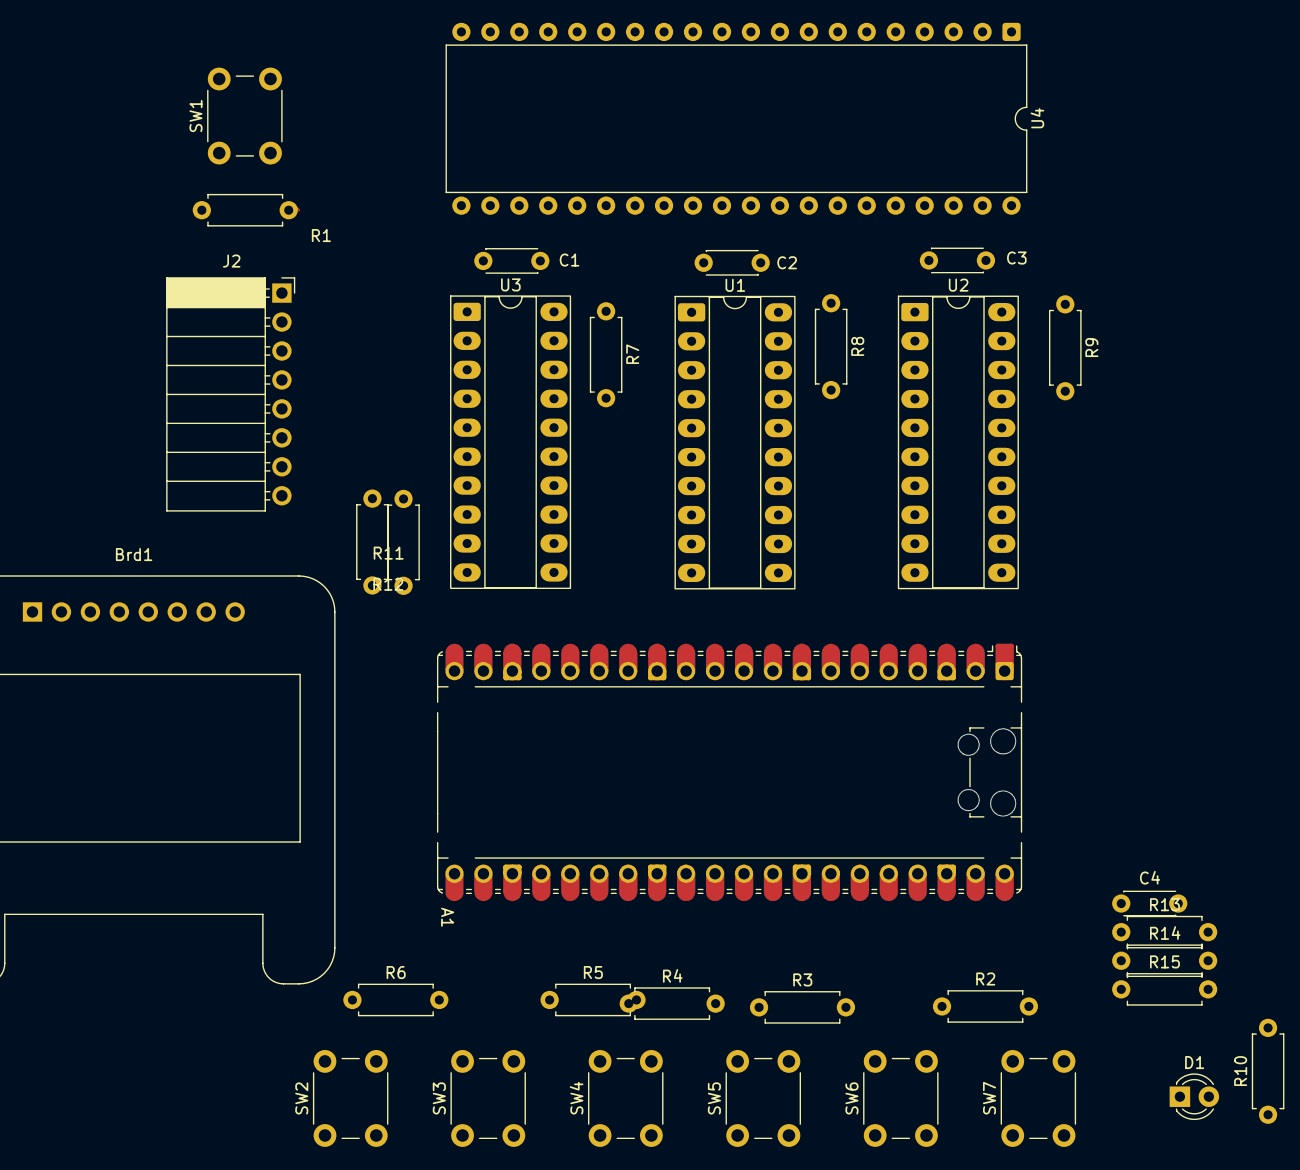
[picture p35: board main.kicad_pcb from above]

Board: 2 copper layers, 34 parts (0 on the bottom side), 63 nets.
