TurBoss/z80neo/firmware/z80neo/src/memory.c

// memory.c — GPIO-based Z80 bus handler (PWM ISR)
// Z80NEO Firmware — Memory, bus, & file I/O module
// TurBoss 2026

#include <stdarg.h>
#include <stdbool.h>
#include <stdint.h>
#include <stdio.h>
#include <stdlib.h>
#include <string.h>

#include <pico/stdlib.h>
#include <pico/time.h>
#include <hardware/gpio.h>
#include <hardware/irq.h>
#include <hardware/pwm.h>
#include <hardware/uart.h>
#include <hardware/flash.h>
#include <hardware/sync.h>

#include "ff.h"
#include "tf_card.h"

#include "display.h"
#include "memory.h"
#include "fileio.h"
#include "midi.h"
#include "i2c_ee.h"
#include "spi_vdp.h"
#include "cpm_disk.h"
#include "fuzix_disk.h"
#include "screensaver.h"

// ===========================================================================
// Globals
// ===========================================================================

uint8_t ram[MAX_BANKS][(uint16_t)RAM_SIZE] = {};

uint8_t *psram_base = NULL;

volatile uint8_t cur_bank = 0;

volatile uint16_t m_adr = 0x0000;

volatile uint8_t io_r_op  = 0x00;
volatile uint8_t io_w_op  = 0x00;
volatile uint8_t mem_r_op = 0x00;
volatile uint8_t mem_w_op = 0x00;

char    rx_buffer[UART_BUF_SIZE];
uint16_t rx_count         = 0;
uint16_t rx_index         = 0;
uint16_t rx_read          = 0;
bool    rx_data_available = false;

volatile uint8_t serial_status_1 = 0x02;
uint8_t  tx_buffer[UART_TX_BUF_SIZE];
uint16_t tx_head = 0;
uint16_t tx_tail = 0;
uint16_t tx_count = 0;

// Second UART (SIO channel B) — UART1 on GPIO36/37, ports 0x90/0x91.  Same
// software-ring scheme as the console, but with no local-echo filtering (it is
// a separate physical link) and no Fuzix serial interrupt.
char     rx1_buffer[UART_BUF_SIZE];
uint16_t rx1_count = 0;
uint16_t rx1_index = 0;
uint16_t rx1_read  = 0;
bool     rx1_data_available = false;

volatile uint8_t serial_status_2 = 0x02;
uint8_t  tx1_buffer[UART_TX_BUF_SIZE];
uint16_t tx1_head = 0;
uint16_t tx1_tail = 0;
uint16_t tx1_count = 0;

// Terminal local-echo cancellation.  If the terminal echoes what the Pico
// sends, that echo arrives on RX and the Z80 reads its own output back as
// input (which makes the CCP see spurious commands / Ctrl-C -> warm-boot loop).
// Track recently transmitted bytes together with their send time; an RX byte
// that matches the oldest un-echoed byte *within the round-trip window* is the
// terminal's echo and is dropped.  The time window is what keeps a terminal
// with local echo OFF from losing genuine keystrokes that happen to repeat a
// character the Z80 just printed (that match arrives far later than an echo).
#define ECHO_FIFO_SIZE 64
#define ECHO_WINDOW_US 30000   // 30 ms — longer than a byte's round trip

static uint8_t  echo_fifo[ECHO_FIFO_SIZE];
static uint32_t echo_time[ECHO_FIFO_SIZE];
static uint16_t echo_head = 0, echo_tail = 0, echo_count = 0;

void echo_track_tx(uint8_t c) {
    if (echo_count >= ECHO_FIFO_SIZE) {
        // More output than can still be in flight as echo — evict the oldest
        // so the FIFO always holds the most recent transmissions.
        echo_tail = (echo_tail + 1) % ECHO_FIFO_SIZE;
        echo_count--;
    }
    echo_fifo[echo_head] = c;
    echo_time[echo_head] = time_us_32();
    echo_head = (echo_head + 1) % ECHO_FIFO_SIZE;
    echo_count++;
}

static bool echo_filter_rx(uint8_t c) {
    if (echo_count == 0) return false;
    if (echo_fifo[echo_tail] != c) return false;
    if ((uint32_t)(time_us_32() - echo_time[echo_tail]) > ECHO_WINDOW_US)
        return false;   // stale match — real input, not an echo
    echo_tail = (echo_tail + 1) % ECHO_FIFO_SIZE;
    echo_count--;
    return true;        // drop: terminal echoed our own output
}

uint32_t d_adr = 0;
uint32_t dr_op = 0;
uint32_t dw_op = 0;
uint32_t io_op = 0;

uint32_t bus_mask = 0;

volatile bool disabled  = false;
volatile bool system_up = false;    // set by main() after boot — gates display-loop Z80 control

volatile uint16_t CANCEL2_ADC = 0xFFF;
volatile uint16_t CANCEL_ADC  = 0xBFF;
volatile uint16_t OK_ADC      = 0x7FF;
volatile uint16_t BACK_ADC    = 0x5FF;
volatile uint16_t DOWN_ADC    = 0x2FF;
volatile uint16_t UP_ADC      = 0x0FF;

volatile bool DEBUG_ADC = false;

// Console baud rate.  Defaults to BAUD_RATE, overridable from Z80NEO.INI.
uint32_t UART_BAUD = BAUD_RATE;

// Second-UART line settings.  Defaults to 115200 8N1; overridable from
// Z80NEO.INI and through the config ports (see uart1_configure).
uint32_t UART1_BAUD      = BAUD_RATE;
uint8_t  UART1_DATA_BITS = DATA_BITS;
uint8_t  UART1_STOP_BITS = STOP_BITS;
uint8_t  UART1_PARITY    = UART_PARITY_NONE;

// Baud codes accepted on port 0x92 (index into this table) and reported back on
// a read.  Code 0xFF means "not one of the standard rates".
static const uint32_t uart1_baud_codes[] = {
    115200, 57600, 38400, 19200, 9600, 4800, 2400, 1200, 600, 300,
    31250,   // code 10: MIDI rate (the Z80 MIDI player selects this)
};
#define UART1_BAUD_CODE_COUNT (sizeof(uart1_baud_codes) / sizeof(uart1_baud_codes[0]))

static uint8_t uart1_baud_code(uint32_t baud) {
    for (uint8_t i = 0; i < UART1_BAUD_CODE_COUNT; i++)
        if (uart1_baud_codes[i] == baud) return i;
    return 0xFF;
}

// Format byte: bits[1:0] = data bits - 5 (so 5..8 -> 0..3), bit3 = 2 stop bits,
// bits[5:4] = parity (0 none, 1 even, 2 odd).  Bit7 is set on a read to mark a
// firmware that implements this port (0x00 from an older firmware instead).
#define UART1_FMT_VALID 0x80

static uint8_t uart1_fmt_byte(void) {
    return (uint8_t)(UART1_FMT_VALID |
                     ((UART1_DATA_BITS - 5) & 0x03) |
                     ((UART1_STOP_BITS == 2) ? 0x08 : 0x00) |
                     ((UART1_PARITY & 0x03) << 4));
}

static void uart1_fmt_decode(uint8_t f, uint8_t *data_bits, uint8_t *stop_bits, uint8_t *parity) {
    uint8_t p = (f >> 4) & 0x03;
    *data_bits = (uint8_t)(5 + (f & 0x03));
    *stop_bits = (f & 0x08) ? 2 : 1;
    *parity    = (p > 2) ? 0 : p;
}

// Fuzix support.  `fuzix_mode` is set from Z80NEO.INI, changes the HEX loader
// to a full-RAM (non-replicating) load and enables the hardware /INT timer.
volatile bool    fuzix_mode = false;
volatile uint8_t fuzix_irq_pending = 0;

void fuzix_int_raise(uint8_t bit) {
    if (!fuzix_mode) return;
    fuzix_irq_pending |= bit;
    gpio_put(INT_OUT, 0);       // assert /INT (active low)
}

// Console (port 0x80) traffic ring: bit7 set = Z80 write, clear = Z80 read.
volatile uint8_t  diag_con[64];
volatile uint32_t diag_con_idx = 0;

bool spi_configured;

char    MACHINE[FILE_LENGTH] = "Z80 CPU";
char    BANK_PROG[4][FILE_LENGTH];

volatile uint32_t last_bytes_loaded = 0;

// ===========================================================================
// Helpers
// ===========================================================================

int decode_hex(char c) {
    if (c >= '0' && c <= '9') return c - '0';
    if (c >= 'A' && c <= 'F') return c - 'A' + 10;
    if (c >= 'a' && c <= 'f') return c - 'a' + 10;
    return -1;
}

// ===========================================================================
// Bank management
// ===========================================================================

void clear_bank(uint8_t bank) {
    if (bank < MAX_BANKS) {
        for (uint16_t adr = 0; adr < RAM_SIZE; adr++)
            ram[bank][adr] = 0;
        if (bank < 4) memset(BANK_PROG[bank], 0, FILE_LENGTH);
    } else if (psram_base) {
        volatile uint8_t *p = psram_base + (bank - MAX_BANKS) * RAM_SIZE;
        for (uint16_t adr = 0; adr < RAM_SIZE; adr++)
            p[adr] = 0;
    }
}

// ===========================================================================
// MMU
// ===========================================================================

#define MMU_PHYS_START   0x20
#define MMU_PHYS_PAGES   32

static uint8_t mmu_page[4] = {
    MMU_PHYS_START + 0,
    MMU_PHYS_START + 1,
    MMU_PHYS_START + 2,
    MMU_PHYS_START + 3
};

static inline uint8_t phys_to_bank(uint8_t phys_page) {
    return (phys_page - MMU_PHYS_START) % MAX_BANKS;
}

uint8_t mmu_read(uint16_t addr) {
    uint8_t page = (addr >> 14) & 0x03;
    return ram[phys_to_bank(mmu_page[page])][addr & 0x3FFF];
}

// After load_init_progs, lock RST vectors against accidental Z80 writes
static volatile bool rst_locked = false;

// Diagnostics: track writes that land in the BIOS code area (0xEB00-0xEE00)
volatile uint16_t diag_bios_wr_addr = 0;
volatile uint8_t  diag_bios_wr_data = 0;
volatile uint32_t diag_bios_wr_count = 0;

// Diagnostics: track the value the hex loader stores at 0xEBEE
volatile uint8_t  diag_hex_ebee = 0;
volatile uint32_t diag_hex_ebee_count = 0;
volatile char     diag_hex_raw[64] = {0};

void mmu_write(uint16_t addr, uint8_t data) {
    // z80neo: write-protect only the JP opcode byte at 0x0000 in bank 0.  The
    // BIOS installs the warm-boot vector as LD (0001H),HL (bytes 0x0001/0x0002
    // = WBOOT), so those must stay writable or every warm boot falls back to
    // the loader's cold-boot JP and reprints the signon.  rst_locked protects
    // against errant Z80 code corrupting the restart opcode itself.
    // CP/M locks the reset vector after loading.  Fuzix installs its own
    // trap vector at 0x0000 from program_vectors, so let it through.
    if (!fuzix_mode && rst_locked && addr == 0 && mmu_page[0] == 0x20) return;
    if (addr >= 0xEB00 && addr <= 0xEE00) {
        diag_bios_wr_addr = addr;
        diag_bios_wr_data = data;
        diag_bios_wr_count++;
    }
    uint8_t page = (addr >> 14) & 0x03;
    ram[phys_to_bank(mmu_page[page])][addr & 0x3FFF] = data;
}

// ===========================================================================
// I/O device handler — UART + MMU ports (handled by GPIO IRQ on IORQ)
// ===========================================================================

static void uart1_rx_poll(void);
static char read_uart1_char(void);

uint8_t io_read_port(uint8_t port) {
    switch (port) {
    case SERIAL_PORT_1:  // 0x80 — serial data (repo build)
    case 0x83: {         // 0x83 — serial data (older SD-card build)
        // Pick up anything the main loop has not drained yet.  read_uart_char()
        // returns 0 only when the ring is empty; with the bus settle fixed the
        // Z80 no longer samples this port ahead of CONSTAT, so a spurious NUL
        // (which CP/M would echo as '^@') does not occur.
        uart_rx_poll();
        uint8_t ch = read_uart_char();
        rx_data_available = (rx_count > 0);
        serial_status_1 = rx_data_available ? (serial_status_1 | 0x01) : (serial_status_1 & ~0x01);
        diag_con[diag_con_idx++ & 63] = ch & 0x7F;
        return ch;
    }
    case 0xD1: return i2c_ee_read();
    case FUZIX_IRQ_STATUS: {
        // Fuzix interrupt acknowledge: return the latched source bits and
        // release /INT.  The Z80 ISR at 0x0038 reads this exactly once.
        uint8_t v = fuzix_irq_pending;
        fuzix_irq_pending = 0;
        gpio_put(INT_OUT, 1);
        return v;
    }
    case 0xE0:
        if (fuzix_mode) return fuzix_disk_read_port(0xE0);
        return cpm_disk_read_port(0xE0);
    case 0xE2: return cpm_disk_read_port(0xE2);
    case 0xE7:
        if (fuzix_mode) return fuzix_disk_read_port(0xE7);
        return 0x00;
    case SERIAL_STATUS_1:
        // Drain the HW FIFO first so a byte already received is reflected, then
        // derive the ready bit from the ring itself.  rx_data_available can go
        // stale (set without a ring byte), and a stale "ready" makes CONSTAT
        // lie: the Z80 then reads a phantom byte, and CP/M echoes it as '^@'.
        uart_rx_poll();
        rx_data_available = (rx_count > 0);
        serial_status_1 = rx_data_available ? (serial_status_1 | 0x01) : (serial_status_1 & ~0x01);
        return serial_status_1;
    case SERIAL_PORT_2: {   // 0x90 — second UART (UART1) data
        uart1_rx_poll();
        uint8_t ch = (uint8_t)read_uart1_char();
        rx1_data_available = (rx1_count > 0);
        serial_status_2 = rx1_data_available ? (serial_status_2 | 0x01) : (serial_status_2 & ~0x01);
        return ch;
    }
    case SERIAL_STATUS_2:   // 0x91 — second UART status (bit0 RX, bit1 TX)
        uart1_rx_poll();
        rx1_data_available = (rx1_count > 0);
        serial_status_2 = rx1_data_available ? (serial_status_2 | 0x01) : (serial_status_2 & ~0x01);
        return serial_status_2;
    case SERIAL_CFG_BAUD: return uart1_baud_code(UART1_BAUD);
    case SERIAL_CFG_FMT:  return uart1_fmt_byte();
    case 0x95: return vdp_status;   // NullVDP link status (bit0 TX, bit1 RX, bit7 present)
    case FILE_CMD:        return fileio_status_read();
    case FILE_NAME:       return fileio_name_read();
    case FILE_DATA:       return fileio_data_read();
    case FILE_ARG0:
    case FILE_ARG0 + 1:
    case FILE_ARG0 + 2:
    case FILE_ARG0 + 3:
        return fileio_arg_read((uint8_t)(port - FILE_ARG0));
    case 0xF0: return mmu_page[0];
    case 0xF1: return mmu_page[1];
    case 0xF2: return mmu_page[2];
    case 0xF3: return mmu_page[3];
    default: return 0x00;
    }
}

void io_write_port(uint8_t port, uint8_t data) {
    switch (port) {
    case SERIAL_PORT_1:  // 0x80 — serial data (repo build)
    case 0x83:           // 0x83 — serial data (older SD-card build)
        diag_con[diag_con_idx++ & 63] = data | 0x80;
        if (tx_count < UART_TX_BUF_SIZE) {
            tx_buffer[tx_head++] = data;
            if (tx_head >= UART_TX_BUF_SIZE) tx_head = 0;
            tx_count++;
        }
        serial_status_1 = (tx_count < UART_TX_BUF_SIZE) ? (serial_status_1 | 0x02) : (serial_status_1 & ~0x02);
        break;
    case SERIAL_PORT_2:  // 0x90 — second UART (UART1) data
        if (tx1_count < UART_TX_BUF_SIZE) {
            tx1_buffer[tx1_head++] = data;
            if (tx1_head >= UART_TX_BUF_SIZE) tx1_head = 0;
            tx1_count++;
        }
        serial_status_2 = (tx1_count < UART_TX_BUF_SIZE) ? (serial_status_2 | 0x02) : (serial_status_2 & ~0x02);
        break;
    case SERIAL_CFG_BAUD: {  // 0x92 — baud code (index into uart1_baud_codes)
        if (data < UART1_BAUD_CODE_COUNT)
            uart1_configure(uart1_baud_codes[data], UART1_DATA_BITS, UART1_STOP_BITS, UART1_PARITY);
        break;
    }
    case SERIAL_CFG_FMT: {   // 0x93 — format byte
        uint8_t db, sb, par;
        uart1_fmt_decode(data, &db, &sb, &par);
        uart1_configure(UART1_BAUD, db, sb, par);
        break;
    }
    case 0x94: vdp_console_tx(data); break;   // NullVDP console byte (mirror also used)
    case FILE_CMD:  fileio_cmd_write(data); break;
    case FILE_NAME: fileio_name_write(data); break;
    case FILE_RST:  fileio_name_reset(); break;
    case FILE_ARG0:
    case FILE_ARG0 + 1:
    case FILE_ARG0 + 2:
    case FILE_ARG0 + 3:
        fileio_arg_write((uint8_t)(port - FILE_ARG0), data);
        break;
    case 0xF0: mmu_page[0] = data; break;
    case 0xF1: mmu_page[1] = data; break;
    case 0xF2: mmu_page[2] = data; break;
    case 0xF3: mmu_page[3] = data; break;
    case 0xD1: i2c_ee_write(data); return;
    case FUZIX_IRQ_STATUS: fuzix_irq_pending = 0; gpio_put(INT_OUT, 1); return;
    case 0xE0:
        if (fuzix_mode) { fuzix_disk_write_port(0xE0, data); return; }
        cpm_disk_write_port(0xE0, data); return;
    case 0xE1: cpm_disk_write_port(0xE1, data); return;
    case 0xE2: cpm_disk_write_port(0xE2, data); return;
    case 0xE3: cpm_disk_write_port(0xE3, data); return;  // drive select
    case 0xE4: case 0xE5: case 0xE6: case 0xE7:
        if (fuzix_mode) fuzix_disk_write_port(port, data);
        return;
    case SERIAL_STATUS_1:
    default: break;
    }
}

// ===========================================================================
// Reset
// ===========================================================================

void reset_release(void) {
    gpio_set_dir(RESET_OUT, GPIO_OUT);
    gpio_put(RESET_OUT, true);
}

void reset_hold(void) {
    gpio_set_dir(RESET_OUT, GPIO_OUT);
    gpio_put(RESET_OUT, false);
}

// ===========================================================================
// Bus control (used by IO handler only — PIO handles memory cycles)
// ===========================================================================

void set_bus_dir(int direction) {
    if (direction) gpio_set_dir_masked(bus_mask, bus_mask);
    else           gpio_set_dir_masked(bus_mask, 0);
}

// ===========================================================================
// UART
// ===========================================================================

// Drain the hardware UART RX FIFO into the software ring.  Single place that
// touches rx_index/rx_read/rx_count so the main loop and the I/O port handler
// cannot disagree about the buffer state.  If the ring is full the oldest byte
// is dropped (console type-ahead semantics).
void uart_rx_poll(void) {
    while (uart_is_readable(UART_ID)) {
        uint8_t c = uart_getc(UART_ID);
        if (echo_filter_rx(c)) continue;  // terminal local echo — drop it
        if (rx_count >= UART_BUF_SIZE) {
            rx_read = (rx_read + 1) % UART_BUF_SIZE;
            rx_count--;
        }
        rx_buffer[rx_index] = c;
        rx_index = (rx_index + 1) % UART_BUF_SIZE;
        rx_count++;
        rx_data_available = true;
        if (fuzix_mode) fuzix_int_raise(FUZIX_IRQ_SERIAL);
    }
}

char read_uart_char(void) {
    // Only return from software buffer — main loop drains UART FIFO
    if (rx_count > 0) {
        char ch = rx_buffer[rx_read];
        rx_read = (rx_read + 1) % UART_BUF_SIZE;
        rx_count--;
        if (!rx_count) rx_data_available = false;
        return ch;
    }
    rx_data_available = false;
    return 0;
}

// Inject a byte into the console RX ring (keyboard input from the VDP link, or
// any other source that is not the UART).  Same ring the Z80 reads on port
// 0x80; oldest byte dropped when full.
void console_inject_rx(uint8_t c) {
    if (rx_count >= UART_BUF_SIZE) {
        rx_read = (rx_read + 1) % UART_BUF_SIZE;
        rx_count--;
    }
    rx_buffer[rx_index] = (char)c;
    rx_index = (rx_index + 1) % UART_BUF_SIZE;
    rx_count++;
    rx_data_available = true;
    if (fuzix_mode) fuzix_int_raise(FUZIX_IRQ_SERIAL);
}

// Firmware-side console writes.  These enqueue into the same TX ring the Z80
// console port (0x80) feeds, so firmware UI and Z80 output stay ordered, and
// the main-loop drain runs echo_track_tx() on every byte regardless of source.
// On a full ring the byte is dropped: the MIDI panel throttles itself well
// below the UART drain rate, so this is only a safety valve.
void console_putc(uint8_t c) {
    if (tx_count >= UART_TX_BUF_SIZE) return;
    tx_buffer[tx_head++] = c;
    if (tx_head >= UART_TX_BUF_SIZE) tx_head = 0;
    tx_count++;
    serial_status_1 = (tx_count < UART_TX_BUF_SIZE) ? (serial_status_1 | 0x02)
                                                    : (serial_status_1 & ~0x02);
}

void console_puts(const char *s) {
    while (*s) console_putc((uint8_t)*s++);
}

void console_write(const uint8_t *s, uint16_t n) {
    while (n--) console_putc(*s++);
}

void uart_status_handler(void) {
    while (tx_count > 0 && uart_is_writable(UART_ID)) {
        uart_putc(UART_ID, tx_buffer[tx_tail]);
        tx_tail = (tx_tail + 1) % UART_TX_BUF_SIZE;
        tx_count--;
    }
    uart_rx_poll();
    rx_data_available = (rx_count > 0);
    serial_status_1 = (uart_is_writable(UART_ID) && tx_count < UART_TX_BUF_SIZE)
                      ? (serial_status_1 | 0x02) : (serial_status_1 & ~0x02);
    if (rx_data_available) serial_status_1 |= 0x01;
    else                   serial_status_1 &= ~0x01;
}

// ===========================================================================
// Second UART (UART1) — SIO channel B on ports 0x90/0x91
// ===========================================================================

void uart1_init(void) {
    uart_init(UART1_ID, UART1_BAUD);
    gpio_pull_up(UART1_RX_PIN);
    gpio_set_function(UART1_TX_PIN, UART_FUNCSEL_NUM(UART1_ID, UART1_TX_PIN));
    gpio_set_function(UART1_RX_PIN, UART_FUNCSEL_NUM(UART1_ID, UART1_RX_PIN));
    // MIDI OUT drives an opto through a current-limiting resistor.  The default
    // 4 mA pad drive can sag under the LED load (3.3 V, ~220 ohm -> ~9 mA) and
    // round the edges; drive hard with fast slew so the LED current is clean at
    // 31.25 kBd.  Harmless for a plain TTL link.
    gpio_set_drive_strength(UART1_TX_PIN, GPIO_DRIVE_STRENGTH_12MA);
    gpio_set_slew_rate(UART1_TX_PIN, GPIO_SLEW_RATE_FAST);
    uart_set_baudrate(UART1_ID, UART1_BAUD);
    uart_set_hw_flow(UART1_ID, false, false);
    uart_set_format(UART1_ID, UART1_DATA_BITS, UART1_STOP_BITS, UART1_PARITY);
}

// Re-tune UART1 at runtime (INI or config ports).  Invalid values are ignored
// so a malformed write cannot leave the line in a broken state.  The GPIO mux
// set by uart1_init() is left untouched.
void uart1_configure(uint32_t baud, uint8_t data_bits, uint8_t stop_bits, uint8_t parity) {
    if (baud < 300 || baud > 3000000) return;
    if (data_bits < 5 || data_bits > 8) return;
    if (stop_bits != 1 && stop_bits != 2) return;
    if (parity > UART_PARITY_ODD) return;

    UART1_BAUD      = baud;
    UART1_DATA_BITS = data_bits;
    UART1_STOP_BITS = stop_bits;
    UART1_PARITY    = parity;

    uart_set_baudrate(UART1_ID, baud);
    uart_set_format(UART1_ID, data_bits, stop_bits, parity);
    uart_set_hw_flow(UART1_ID, false, false);
}

static void uart1_rx_poll(void) {
    while (uart_is_readable(UART1_ID)) {
        uint8_t c = uart_getc(UART1_ID);
        if (rx1_count >= UART_BUF_SIZE) {
            rx1_read = (rx1_read + 1) % UART_BUF_SIZE;
            rx1_count--;
        }
        rx1_buffer[rx1_index] = c;
        rx1_index = (rx1_index + 1) % UART_BUF_SIZE;
        rx1_count++;
        rx1_data_available = true;
    }
}

static char read_uart1_char(void) {
    if (rx1_count > 0) {
        char ch = rx1_buffer[rx1_read];
        rx1_read = (rx1_read + 1) % UART_BUF_SIZE;
        rx1_count--;
        if (!rx1_count) rx1_data_available = false;
        return ch;
    }
    rx1_data_available = false;
    return 0;
}

void uart1_poll(void) {
    while (tx1_count > 0 && uart_is_writable(UART1_ID)) {
        uart_putc(UART1_ID, tx1_buffer[tx1_tail]);
        tx1_tail = (tx1_tail + 1) % UART_TX_BUF_SIZE;
        tx1_count--;
    }
    uart1_rx_poll();
    rx1_data_available = (rx1_count > 0);
    serial_status_2 = (uart_is_writable(UART1_ID) && tx1_count < UART_TX_BUF_SIZE)
                      ? (serial_status_2 | 0x02) : (serial_status_2 & ~0x02);
    if (rx1_data_available) serial_status_2 |= 0x01;
    else                    serial_status_2 &= ~0x01;
}

// ===========================================================================
// SD card
// ===========================================================================

static FRESULT fr;
static FATFS   fs;
static FIL     fil;
static char    cwdbuf[FF_LFN_BUF] = {0};

char *init_and_mount_sd_card(void) {
    char fr_buf[10];
    memset(&cwdbuf, 0, FF_LFN_BUF);
    if (!spi_configured) show_error_and_halt("SD INIT ERR1");
    fr = f_mount(&fs, "", 1);
    if (fr != FR_OK) { sprintf(fr_buf, "SD INIT ERR2 %d", fr); show_error_and_halt(fr_buf); }
    fr = f_getcwd(cwdbuf, sizeof cwdbuf);
    if (FR_OK != fr) show_error_and_halt("SD INIT ERR3");
    return cwdbuf;
}

// ===========================================================================
// Z80NEO.INI reader
// ===========================================================================

// Case-insensitive key comparison (both NUL-terminated).
static bool ini_key_is(const char *k, const char *name) {
    while (*k && *name) {
        char a = *k, b = *name;
        if (a >= 'a' && a <= 'z') a -= 32;
        if (b >= 'a' && b <= 'z') b -= 32;
        if (a != b) return false;
        k++; name++;
    }
    return *k == '\0' && *name == '\0';
}

// Trim leading/trailing spaces, tabs and CR/LF in place; returns the start.
static char *ini_trim(char *s) {
    while (*s == ' ' || *s == '\t') s++;
    char *end = s + strlen(s);
    while (end > s && (end[-1] == ' ' || end[-1] == '\t' ||
                       end[-1] == '\r' || end[-1] == '\n'))
        end--;
    *end = '\0';
    return s;
}

// Split a "KEY=VALUE" line (also accepts ':' or whitespace) in place.  Returns
// the trimmed value, or NULL for blank/comment lines.  Key lands in `key`.
static const char *ini_split(char *line, char *key, size_t keysz) {
    char *p = ini_trim(line);
    if (*p == '\0' || *p == '#' || *p == ';') return NULL;
    char *e = p;
    while (*e && *e != '=' && *e != ':' && *e != ' ' && *e != '\t') e++;
    size_t n = (size_t)(e - p);
    if (n >= keysz) n = keysz - 1;
    memcpy(key, p, n); key[n] = '\0';
    char *v = e;
    while (*v == ' ' || *v == '\t' || *v == '=' || *v == ':') v++;
    return ini_trim(v);
}

// Decode three hex digits into an ADC threshold.
static bool ini_hex3(const char *v, volatile uint16_t *dst) {
    if (strlen(v) < 3) return false;
    int d0 = decode_hex(v[0]), d1 = decode_hex(v[1]), d2 = decode_hex(v[2]);
    if (d0 < 0 || d1 < 0 || d2 < 0) return false;
    *dst = (uint16_t)(d0 * 256 + d1 * 16 + d2);
    return true;
}

// Parse an "8N1"-style line format: data bits 5..8, parity N/E/O, stop bits 1/2.
static bool ini_parse_format(const char *v, uint8_t *data_bits, uint8_t *parity, uint8_t *stop_bits) {
    char d = v[0], p = v[1], s = v[2];
    if (d < '5' || d > '8') return false;
    uint8_t par;
    if (p == 'N' || p == 'n') par = UART_PARITY_NONE;
    else if (p == 'E' || p == 'e') par = UART_PARITY_EVEN;
    else if (p == 'O' || p == 'o') par = UART_PARITY_ODD;
    else return false;
    if (s != '1' && s != '2') return false;
    *data_bits = (uint8_t)(d - '0');
    *parity    = par;
    *stop_bits = (uint8_t)(s - '0');
    return true;
}

// Apply one named "KEY=VALUE" Z80NEO.INI line.  Unknown keys are ignored so a
// file written for a newer firmware still boots.
static void ini_apply_named(char *line) {
    char key[16];
    const char *v = ini_split(line, key, sizeof(key));
    if (v == NULL) return;

    if (ini_key_is(key, "MACHINE")) {
        snprintf(MACHINE, sizeof(MACHINE), "%s", v);
        print_line(0, "%s", MACHINE);
    } else if (ini_key_is(key, "CANCEL2")) {
        ini_hex3(v, &CANCEL2_ADC);
        print_line(0, "CANCEL2: %03x", CANCEL2_ADC);
    } else if (ini_key_is(key, "CANCEL")) {
        ini_hex3(v, &CANCEL_ADC);
        print_line(0, "CANCEL : %03x", CANCEL_ADC);
    } else if (ini_key_is(key, "OK")) {
        ini_hex3(v, &OK_ADC);
        print_line(0, "OK     : %03x", OK_ADC);
    } else if (ini_key_is(key, "BACK")) {
        ini_hex3(v, &BACK_ADC);
        print_line(0, "BACK   : %03x", BACK_ADC);
    } else if (ini_key_is(key, "DOWN")) {
        ini_hex3(v, &DOWN_ADC);
        print_line(0, "DOWN   : %03x", DOWN_ADC);
    } else if (ini_key_is(key, "UP")) {
        ini_hex3(v, &UP_ADC);
        print_line(0, "UP     : %03x", UP_ADC);
    } else if (ini_key_is(key, "PROG1")) {
        snprintf(BANK_PROG[0], FILE_LENGTH, "%s", v);
        print_line(0, "P1: %12s", BANK_PROG[0]);
    } else if (ini_key_is(key, "PROG2")) {
        snprintf(BANK_PROG[1], FILE_LENGTH, "%s", v);
        print_line(0, "P2: %12s", BANK_PROG[1]);
    } else if (ini_key_is(key, "PROG3")) {
        snprintf(BANK_PROG[2], FILE_LENGTH, "%s", v);
        print_line(0, "P3: %12s", BANK_PROG[2]);
    } else if (ini_key_is(key, "PROG4")) {
        snprintf(BANK_PROG[3], FILE_LENGTH, "%s", v);
        print_line(0, "P4: %12s", BANK_PROG[3]);
    } else if (ini_key_is(key, "DEBUG")) {
        DEBUG_ADC = (v[0] == '1');
        print_line(0, "ADC DEBUG: %01x", DEBUG_ADC);
    } else if (ini_key_is(key, "FUZIX")) {
        fuzix_mode = (v[0] == 'F' || v[0] == 'f' || v[0] == '1');
        print_line(0, "FUZIX: %01x", fuzix_mode);
    } else if (ini_key_is(key, "BAUD")) {
        long b = atol(v);
        if (b >= 300 && b <= 3000000) UART_BAUD = (uint32_t)b;
        print_line(0, "BAUD: %lu", (unsigned long)UART_BAUD);
    } else if (ini_key_is(key, "UART1_BAUD")) {
        long b = atol(v);
        if (b >= 300 && b <= 3000000) UART1_BAUD = (uint32_t)b;
        print_line(0, "U1 BAUD: %lu", (unsigned long)UART1_BAUD);
    } else if (ini_key_is(key, "UART1_FORMAT")) {
        uint8_t db, par, sb;
        if (ini_parse_format(v, &db, &par, &sb)) {
            UART1_DATA_BITS = db;
            UART1_PARITY    = par;
            UART1_STOP_BITS = sb;
        }
        char pc = (UART1_PARITY == UART_PARITY_EVEN) ? 'E'
                  : (UART1_PARITY == UART_PARITY_ODD) ? 'O' : 'N';
        print_line(0, "U1 FMT: %u%c%u", UART1_DATA_BITS, pc, UART1_STOP_BITS);
    } else if (ini_key_is(key, "MIDI_GROUP_X10")) {
        long g = atol(v);
        if (g >= 0 && g <= 1000) midi_credit_group_x10 = (uint32_t)g;
        print_line(0, "MD GRP: %lu", (unsigned long)midi_credit_group_x10);
    } else if (ini_key_is(key, "MIDI_BYTE_X10")) {
        long b = atol(v);
        if (b >= 0 && b <= 1000) midi_credit_byte_x10 = (uint32_t)b;
        print_line(0, "MD BYT: %lu", (unsigned long)midi_credit_byte_x10);
    } else if (ini_key_is(key, "MIDI_PANEL")) {
        midi_panel_set_enabled(v[0] == '1' || v[0] == 'O' || v[0] == 'o' ||
                               v[0] == 'Y' || v[0] == 'y');
        print_line(0, "MIDI PNL: %s", midi_panel_enabled() ? "ON" : "OFF");
    } else if (ini_key_is(key, "Z80_KHZ")) {
        long khz = atol(v);
        if (khz >= 32 && khz <= 1000) CPU_SPEED = (float)khz * 1000.0f;
        print_line(0, "Z80 KHZ: %lu", (unsigned long)(CPU_SPEED / 1000.0f));
    } else if (ini_key_is(key, "Z80_DUTY")) {
        long pct = atol(v);
        if (pct >= 5 && pct <= 95) CPU_DUTY = (float)pct / 100.0f;
        print_line(0, "Z80 DTY: %lu%%", (unsigned long)(CPU_DUTY * 100.0f + 0.5f));
    } else if (ini_key_is(key, "SCREENSAVER")) {
        screensaver_set_enabled(v[0] == '1' || v[0] == 'O' || v[0] == 'o' ||
                                v[0] == 'Y' || v[0] == 'y');
        print_line(0, "SS: %s", screensaver_enabled() ? "ON" : "OFF");
    } else if (ini_key_is(key, "SS_MODE")) {
        int m = atoi(v);
        bool numeric = (v[0] >= '0' && v[0] <= '9');
        if (!numeric) {
            for (int i = 0; i < screensaver_mode_count(); i++)
                if (ini_key_is(v, screensaver_mode_name(i))) { m = i; break; }
        }
        screensaver_set_mode(m);
        print_line(0, "SS MODE: %s", screensaver_mode_name(screensaver_mode()));
    } else if (ini_key_is(key, "SS_IDLE")) {
        long s = atol(v);
        if (s >= 5 && s <= 3600) screensaver_set_idle_seconds((uint32_t)s);
        print_line(0, "SS IDLE: %lus", (unsigned long)screensaver_idle_seconds());
    } else {
        return; // unknown key: ignore
    }
    sleep_ms(DISPLAY_DELAY_SHORT);
}

// Parse an optional trailing "BAUD <n>" (or "BAUD:<n>", "BAUD=<n>") line.
// Case-insensitive.  Returns true and stores the rate only for a sane PL011
// baud value, so the positional debug/FUZIX lines are never mistaken for it.
static bool ini_parse_baud(const char *line, uint32_t *baud) {
    while (*line == ' ' || *line == '\t') line++;
    if (!((line[0] == 'B' || line[0] == 'b') &&
          (line[1] == 'A' || line[1] == 'a') &&
          (line[2] == 'U' || line[2] == 'u') &&
          (line[3] == 'D' || line[3] == 'd')))
        return false;
    const char *p = line + 4;
    while (*p == ' ' || *p == '\t' || *p == ':' || *p == '=') p++;
    long v = atol(p);
    if (v < 300 || v > 3000000) return false;
    *baud = (uint32_t)v;
    return true;
}

int sd_read_init(void) {
    FRESULT fr_local;
    FATFS   fs_local;
    FIL     fil_local;
    int ret;
    TCHAR filename[] = "Z80NEO.INI";
    char buf[FILE_BUFF_SIZE];
    bool skip = false;

    clear_screen();
    if (!spi_configured) { print_string(3, 0, "SPI ERROR"); uart_puts(UART_ID, "SPI ERROR\r\n"); sleep_ms(DISPLAY_DELAY_LONG); skip = true; }

    char tmp_buf[10] = "";
    if (!skip) { fr_local = f_mount(&fs_local, "0", 0);
        if (FR_OK != fr_local) { print_string(3, 0, "MOUNT - ERROR"); uart_puts(UART_ID, "Mount error\r\n"); sleep_ms(DISPLAY_DELAY_LONG); skip = true; }
        else uart_puts(UART_ID, "Mount ok\r\n");
    }

    if (!skip) { fr_local = f_open(&fil_local, filename, FA_READ);
        if (fr_local != FR_OK) { print_string(0, 0, "OPEN - ERROR"); uart_puts(UART_ID, "Open error\r\n"); skip = true; while (true); }
        else uart_puts(UART_ID, "Open ok\r\n");
    }

    // Layout detection: a "KEY=VALUE" (or "KEY:VALUE") first non-comment line
    // selects the named layout; anything else is the legacy positional layout.
    bool named = false;
    if (!skip) {
        while (f_gets(buf, sizeof(buf), &fil_local)) {
            char *t = ini_trim(buf);
            if (*t == '\0' || *t == '#' || *t == ';') continue;
            named = (strchr(t, '=') != NULL || strchr(t, ':') != NULL);
            break;
        }
        f_lseek(&fil_local, 0);
    }

    if (!skip && named) {
        // Named layout: order-independent, unknown keys ignored.
        while (f_gets(buf, sizeof(buf), &fil_local))
            ini_apply_named(buf);
        clear_screen();
    } else if (!skip) {
        // Legacy positional layout.
        while (!skip) {
            if (!f_gets(MACHINE, sizeof(MACHINE), &fil_local)) { show_error(0, 0, "INI - MACHINE"); skip = true; break; }
            print_line(0, MACHINE); sleep_ms(DISPLAY_DELAY_SHORT);

            if (!f_gets(buf, sizeof(buf), &fil_local)) { show_error(0, 0, "INI - CANCEL2"); skip = true; break; }
            CANCEL2_ADC = decode_hex(buf[0]) * 16 * 16 + decode_hex(buf[1]) * 16 + decode_hex(buf[2]);
            print_line(0, "%CANCEL2: %03x     ", CANCEL2_ADC); sleep_ms(DISPLAY_DELAY_SHORT);

            if (!f_gets(buf, sizeof(buf), &fil_local)) { show_error(0, 0, "INI - CANCEL"); skip = true; break; }
            CANCEL_ADC = decode_hex(buf[0]) * 16 * 16 + decode_hex(buf[1]) * 16 + decode_hex(buf[2]);
            print_line(0, "%CANCEL : %03x     ", CANCEL_ADC); sleep_ms(DISPLAY_DELAY_SHORT);

            if (!f_gets(buf, sizeof(buf), &fil_local)) { show_error(0, 0, "INI - OK"); skip = true; break; }
            OK_ADC = decode_hex(buf[0]) * 16 * 16 + decode_hex(buf[1]) * 16 + decode_hex(buf[2]);
            print_line(0, "%OK     : %03x     ", OK_ADC); sleep_ms(DISPLAY_DELAY_SHORT);

            if (!f_gets(buf, sizeof(buf), &fil_local)) { show_error(0, 0, "INI - BACK"); skip = true; break; }
            BACK_ADC = decode_hex(buf[0]) * 16 * 16 + decode_hex(buf[1]) * 16 + decode_hex(buf[2]);
            print_line(0, "%BACK   : %03x     ", BACK_ADC); sleep_ms(DISPLAY_DELAY_SHORT);

            if (!f_gets(buf, sizeof(buf), &fil_local)) { show_error(0, 0, "INI - DOWN"); skip = true; break; }
            DOWN_ADC = decode_hex(buf[0]) * 16 * 16 + decode_hex(buf[1]) * 16 + decode_hex(buf[2]);
            print_line(0, "%DOWN   : %03x     ", DOWN_ADC); sleep_ms(DISPLAY_DELAY_SHORT);

            if (!f_gets(buf, sizeof(buf), &fil_local)) { show_error(0, 0, "INI - UP"); skip = true; break; }
            UP_ADC = decode_hex(buf[0]) * 16 * 16 + decode_hex(buf[1]) * 16 + decode_hex(buf[2]);
            print_line(0, "%UP     : %03x     ", UP_ADC); sleep_ms(DISPLAY_DELAY_SHORT);

            if (!f_gets(BANK_PROG[0], sizeof(BANK_PROG[0]), &fil_local)) { show_error(0, 0, "INI - PROG1"); skip = true; break; }
            print_line(0, "P1: %12s", BANK_PROG[0]); sleep_ms(DISPLAY_DELAY_SHORT);
            if (!f_gets(BANK_PROG[1], sizeof(BANK_PROG[1]), &fil_local)) { show_error(0, 0, "INI - PROG2"); skip = true; break; }
            print_line(0, "P2: %12s", BANK_PROG[1]); sleep_ms(DISPLAY_DELAY_SHORT);
            if (!f_gets(BANK_PROG[2], sizeof(BANK_PROG[2]), &fil_local)) { show_error(0, 0, "INI - PROG3"); skip = true; break; }
            print_line(0, "P3: %12s", BANK_PROG[2]); sleep_ms(DISPLAY_DELAY_SHORT);
            if (!f_gets(BANK_PROG[3], sizeof(BANK_PROG[3]), &fil_local)) { show_error(0, 0, "INI - PROG4"); skip = true; break; }
            print_line(0, "P4: %12s", BANK_PROG[3]); sleep_ms(DISPLAY_DELAY_SHORT);
            break;
        }

        // Legacy optional trailing lines.  A "BAUD <n>" line may appear in any
        // position among them; the remaining lines keep their positional
        // meaning: first = ADC debug flag ("1" = on), second = FUZIX mode.
        int opt = 0;
        for (int n = 0; n < 3 && !skip && f_gets(buf, sizeof(buf), &fil_local); n++) {
            uint32_t baud;
            if (ini_parse_baud(buf, &baud)) {
                UART_BAUD = baud;
                print_line(0, "%BAUD: %lu    ", (unsigned long)UART_BAUD);
                sleep_ms(DISPLAY_DELAY_SHORT); clear_screen();
                continue;
            }
            // A named "KEY=VALUE"/"KEY:VALUE" line is not a positional flag.
            // Without this, a positional mis-detection of a named file turns
            // the leading 'F' of "FUZIX=0" into fuzix_mode=1.
            if (strchr(buf, '=') || strchr(buf, ':'))
                continue;
            if (opt == 0) {
                DEBUG_ADC = buf[0] == '1';
                print_line(0, "%ADC DEBUG: %01x    ", DEBUG_ADC);
            } else {
                fuzix_mode = (buf[0] == 'F' || buf[0] == 'f' || buf[0] == '1');
                print_line(0, "%FUZIX: %01x    ", fuzix_mode);
            }
            opt++;
            sleep_ms(DISPLAY_DELAY_SHORT); clear_screen();
        }
    }
    fr_local = f_close(&fil_local);
    if (fr_local != FR_OK) { show_error(0, 0, "INI - CLOSE"); while (true); }
    f_unmount("0:");
    return 0;
}

// ===========================================================================
// Intel HEX loader (same as before, with bank offset masking)
// ===========================================================================

// Case-insensitive "does name end with ext" (ext includes the dot).
static bool ext_is(const char *name, const char *ext) {
    size_t n = strlen(name), e = strlen(ext);
    if (n < e) return false;
    for (size_t i = 0; i < e; i++) {
        char a = name[n - e + i];
        if (a >= 'A' && a <= 'Z') a += 32;
        if (a != ext[i]) return false;
    }
    return true;
}

bool is_prog_file(const char *name) {
    return ext_is(name, ".hex") || ext_is(name, ".ihx");
}

void load_file(bool quiet) {
    reset_hold();
    FRESULT fr_local;
    FATFS   fs_local;
    FIL     fil_local;
    char buf[FILE_BUFF_SIZE];
    char const *p_dir;

    clear_bank(cur_bank);
    // Fuzix occupies all four kernel pages; wipe them so linker gaps do not
    // retain stale CP/M data.
    if (fuzix_mode) {
        for (uint8_t b = 0; b < 4; b++) clear_bank(b);
    }

    if (!quiet) { clear_screen(); print_string(0, 0, "Loading HEX/IHX"); print_string(0, 1, file); sleep_ms(DISPLAY_DELAY_SHORT); }

    p_dir = init_and_mount_sd_card();
    fr_local = f_open(&fil_local, file, FA_READ);
    if (fr_local != FR_OK) { sleep_ms(DISPLAY_DELAY_LONG); show_error(0, 0, "Can't open file!"); sleep_ms(DISPLAY_DELAY_LONG); show_error(0, 0, file); sleep_ms(DISPLAY_DELAY_LONG); return; }

    uint8_t  intel_checksum         = 0;
    uint8_t  intel_byte_count       = 0;
    uint16_t intel_address          = 0;
    uint8_t  intel_record_type      = 0;
    uint32_t intel_extended_address = 0;
    uint32_t intel_absolute_address = 0;

    uint8_t parser_state = 0;
    uint8_t hex_digit     = 0;
    uint8_t current_byte  = 0;
    uint8_t data_index    = 0;
    uint8_t data_buffer[256];  // max 255 bytes per Intel HEX record

    int      line         = 0;
    uint32_t bytes_loaded = 0;

    if (DEBUG_LOAD) { clear_screen(); print_string(center_string("--HEX LOADER--"), 0, "--HEX LOADER--"); print_string(0, 1, file); print_string(0, 2, "ADDR:          "); print_string(0, 3, "BANK:          "); print_string(0, 4, "DATA:          "); print_string(0, 5, "LINE:          "); }
    uart_puts(UART_ID, "Loading hex\r\n");

    while (true) {
        sprintf(serial_text_buffer, "%c\r", load_chars[load_char_index]); uart_puts(UART_ID, serial_text_buffer);
        load_char_index += 1; if (load_char_index > strlen(load_chars)) load_char_index = 0;
        memset(&buf, 0, sizeof(buf));
        if (!f_gets(buf, sizeof(buf), &fil_local)) break;
        int i = 0;
        if (buf[0] == '\0' || buf[0] == '\r' || buf[0] == '\n') continue;
        if (buf[0] != ':') { sprintf(text_buffer, "Not HEX Line: %d Data: %s", line, buf); uart_puts(UART_ID, text_buffer); clear_screen(); fr_local = f_close(&fil_local); return; }

        parser_state = 1; intel_byte_count = 0; intel_address = 0; intel_record_type = 0; intel_checksum = 0; hex_digit = 0; current_byte = 0; data_index = 0;
        cur_bank = 0; i = 1;

        while (true) {
            byte b = buf[i++];
            if (!b || b == '\n' || b == '\r') break;
            if (b == ' ' || b == '\t') continue;
            int decoded = decode_hex(b);
            if (decoded == -1) { sprintf(text_buffer, "Invalid HEX: Line %05d", line); uart_puts(UART_ID, text_buffer); clear_screen(); fr_local = f_close(&fil_local); return; }

            if (hex_digit == 0) { current_byte = decoded * 16; hex_digit = 1; }
            else { current_byte += decoded; hex_digit = 0;
                if (parser_state < 6) intel_checksum += current_byte;
                switch (parser_state) {
                case 1: intel_byte_count = current_byte; parser_state = 2; break;
                case 2: cur_bank = (current_byte & 0b11000000) >> 6; intel_address = current_byte << 8; parser_state = 3; break;
                case 3: intel_address |= current_byte; parser_state = 4; break;
                case 4: intel_record_type = current_byte; parser_state = (intel_byte_count == 0) ? 6 : (data_index = 0, 5); break;
                case 5: data_buffer[data_index++] = current_byte; if (data_index >= intel_byte_count) parser_state = 6; break;
                case 6:
                    if (intel_address == 0xEBE0) { strncpy((char*)diag_hex_raw, buf, sizeof(diag_hex_raw)-1); }
                    if ((intel_checksum + current_byte) & 0xFF) { sprintf(text_buffer, "Checksum err Line %05d", line); uart_puts(UART_ID, text_buffer); clear_screen(); fr_local = f_close(&fil_local); return; }
                    switch (intel_record_type) {
                    case 0: intel_absolute_address = intel_extended_address + intel_address;
                        { uint16_t bank_offset = intel_absolute_address & 0x3FFF;
                          for (int j = 0; j < intel_byte_count; j++) {
                              uint8_t val = data_buffer[j];
                              uint32_t abs_addr = intel_absolute_address + j;
                              if (abs_addr == 0xEBEE) { diag_hex_ebee = val; diag_hex_ebee_count++; }
                              if (abs_addr < 0x4000 && !fuzix_mode) {
                                  // CP/M bootloader code: replicate to ALL banks
                                  for (int bk = 0; bk < MAX_BANKS; bk++)
                                      ram[bk][bank_offset + j] = val;
                              } else {
                                  // OS/data: put each 16KB page in its own bank
                                  uint8_t page = (abs_addr >> 14) & 0x03;
                                  ram[page][bank_offset + j] = val;
                              }
                              bytes_loaded++;
                          }
                        }
                        break;
                    case 1: break;
                    case 2: if (intel_byte_count == 2) intel_extended_address = (data_buffer[0] << 8 | data_buffer[1]) * 16; break;
                    case 3: case 5: break;
                    case 4: if (intel_byte_count == 2) intel_extended_address = (data_buffer[0] << 8 | data_buffer[1]) << 16; break;
                    default: sprintf(text_buffer, "Unknown type %02X", intel_record_type); print_string(0, 5, text_buffer); break;
                    }
                    parser_state = 0; break;
                }
            }
        }
        line++;
        if (intel_record_type == 1) break;
    }
    fr_local = f_close(&fil_local); if (fr_local != FR_OK) show_error(0, 0, "Can't close file!");
    f_unmount("0:");
    last_bytes_loaded = bytes_loaded;
    if (DEBUG_LOAD) { sprintf(text_buffer, "Loaded %lu bytes", bytes_loaded); uart_puts(UART_ID, text_buffer); uart_puts(UART_ID, "\r\n"); print_string(0, 6, text_buffer); sleep_ms(DISPLAY_DELAY_LONG); }
    if (!quiet) { clear_screen(); sprintf(text_buffer, "Loaded: %lu bytes", bytes_loaded); print_string(0, 0, text_buffer); print_string(0, 1, file); sleep_ms(DISPLAY_DELAY); }
    strcpy(BANK_PROG[cur_bank], file);
    if (fuzix_mode) {
        // Fuzix links its crt0 at 0x0100; the Z80 reset vector is 0x0000, so
        // plant a jump there.  program_vectors() overwrites it later with the
        // NULL trap.
        //
        // Only patch an image that has no reset vector of its own: a page-0
        // program (linked at 0x0000, e.g. the MIDI player) already starts with
        // `JP`, and overwriting it with `JP 0x0100` derails the CPU into the
        // middle of the program — a silent hang that looks like "won't boot".
        // Fuzix's image is zero-filled below 0x0100, so its first byte is 0x00.
        if (ram[0][0] != 0xC3) {
            ram[0][0] = 0xC3;   // JP
            ram[0][1] = 0x00;   // 0x0100
            ram[0][2] = 0x01;
        } else {
            uart_puts(UART_ID, "FUZIX=on: image has its own 0x0000 vector, "
                               "left as-is (set FUZIX=0 for page-0 programs)\r\n");
        }
    }
    reset_release();
}

void load(void) { select_file(); load_file(false); }

void load_init_progs(void) {
    // Load only the first configured program (the hex file contains everything)
    if (BANK_PROG[0][0] >= 48) {
        strcpy(file, BANK_PROG[0]);
        load_file(true);
    }
    cur_bank = 0;
    // Lock RST vectors after loading — hex loader wrote correct bytes,
    // now prevent Z80 from corrupting them during execution.
    rst_locked = true;
}

// Boot-time sanity dump: shows the loaded program and the key page-zero /
// CCP-BDOS / BIOS vectors actually present in the banks.
void post_dump(void) {
    char b[160];
    sprintf(b,
        "POST: pgm=%s bytes=%lu\r\n"
        "  0000: %02X %02X %02X %02X\r\n"
        "  D400: %02X %02X %02X %02X\r\n"
        "  EB00: %02X %02X %02X %02X\r\n",
        BANK_PROG[0], (unsigned long)last_bytes_loaded,
        ram[0][0x0000], ram[0][0x0001], ram[0][0x0002], ram[0][0x0003],
        ram[3][0x1400], ram[3][0x1401], ram[3][0x1402], ram[3][0x1403],
        ram[3][0x2B00], ram[3][0x2B01], ram[3][0x2B02], ram[3][0x2B03]);
    uart_puts(UART_ID, b);
}
