TurBoss/z80neo/vdp/NullVDP/src/font_rom.v

// ============================================================================
// Font ROM - 8x16 pixel monospace font (ASCII 0-127)
// Based on classic IBM VGA font (Code Page 437)
// ============================================================================
//
// Memory layout:
//   - 128 characters x 16 rows = 2048 bytes
//   - addr[10:4] = character code (7 bits)
//   - addr[3:0]  = row within character (4 bits)
//   - Each row is 8 bits (one pixel per bit, MSB leftmost)

module font_rom (
    input            clk,
    input      [10:0] addr,       // {char_code[6:0], row[3:0]}
    output reg [7:0] data         // 8-bit row bitmap
);

    // Font data stored as a packed 2048-byte array
    // 128 chars * 16 rows = 2048 bytes
    reg [7:0] font [0:2047];

    // Initialize font data using readmemh-like approach
    // Using initial block for simulation; synthesis reads from BRAM init
    // For open-source toolchain, we initialize inline

    // Character 0x00 (NUL) - Empty (used as space)
    // Character 0x01 (SOH)
    // ...
    // Character 0x20 (' ') = space
    // Character 0x41 ('A')
    // etc.

    // This is a subset of the font. For full font, we'd need 2048 bytes.
    // We provide the most common printable characters and fill the rest with blanks.

    // We'll use a generate-like approach but simpler: a big case statement
    // in an always block for BRAM initialization.

    integer i;
    initial begin
        // Initialize all to zero first
        for (i = 0; i < 2048; i = i + 1) begin
            font[i] = 8'h00;
        end

        // Space (0x20)
        font[16*8'h20 +  0] = 8'h00;
        font[16*8'h20 +  1] = 8'h00;
        font[16*8'h20 +  2] = 8'h00;
        font[16*8'h20 +  3] = 8'h00;
        font[16*8'h20 +  4] = 8'h00;
        font[16*8'h20 +  5] = 8'h00;
        font[16*8'h20 +  6] = 8'h00;
        font[16*8'h20 +  7] = 8'h00;
        font[16*8'h20 +  8] = 8'h00;
        font[16*8'h20 +  9] = 8'h00;
        font[16*8'h20 + 10] = 8'h00;
        font[16*8'h20 + 11] = 8'h00;
        font[16*8'h20 + 12] = 8'h00;
        font[16*8'h20 + 13] = 8'h00;
        font[16*8'h20 + 14] = 8'h00;
        font[16*8'h20 + 15] = 8'h00;

        // Exclamation mark '!' (0x21)
        font[16*8'h21 +  0] = 8'h00;
        font[16*8'h21 +  1] = 8'h18;
        font[16*8'h21 +  2] = 8'h3C;
        font[16*8'h21 +  3] = 8'h3C;
        font[16*8'h21 +  4] = 8'h3C;
        font[16*8'h21 +  5] = 8'h18;
        font[16*8'h21 +  6] = 8'h18;
        font[16*8'h21 +  7] = 8'h18;
        font[16*8'h21 +  8] = 8'h00;
        font[16*8'h21 +  9] = 8'h18;
        font[16*8'h21 + 10] = 8'h18;
        font[16*8'h21 + 11] = 8'h00;
        font[16*8'h21 + 12] = 8'h00;
        font[16*8'h21 + 13] = 8'h00;
        font[16*8'h21 + 14] = 8'h00;
        font[16*8'h21 + 15] = 8'h00;

        // Double quote '"' (0x22)
        font[16*8'h22 +  0] = 8'h00;
        font[16*8'h22 +  1] = 8'h66;
        font[16*8'h22 +  2] = 8'h66;
        font[16*8'h22 +  3] = 8'h66;
        font[16*8'h22 +  4] = 8'h24;
        font[16*8'h22 +  5] = 8'h00;
        font[16*8'h22 +  6] = 8'h00;
        font[16*8'h22 +  7] = 8'h00;
        font[16*8'h22 +  8] = 8'h00;
        font[16*8'h22 +  9] = 8'h00;
        font[16*8'h22 + 10] = 8'h00;
        font[16*8'h22 + 11] = 8'h00;
        font[16*8'h22 + 12] = 8'h00;
        font[16*8'h22 + 13] = 8'h00;
        font[16*8'h22 + 14] = 8'h00;
        font[16*8'h22 + 15] = 8'h00;

        // Hash '#' (0x23)
        font[16*8'h23 +  0] = 8'h00;
        font[16*8'h23 +  1] = 8'h6C;
        font[16*8'h23 +  2] = 8'h6C;
        font[16*8'h23 +  3] = 8'hFE;
        font[16*8'h23 +  4] = 8'h6C;
        font[16*8'h23 +  5] = 8'h6C;
        font[16*8'h23 +  6] = 8'h6C;
        font[16*8'h23 +  7] = 8'hFE;
        font[16*8'h23 +  8] = 8'h6C;
        font[16*8'h23 +  9] = 8'h6C;
        font[16*8'h23 + 10] = 8'h00;
        font[16*8'h23 + 11] = 8'h00;
        font[16*8'h23 + 12] = 8'h00;
        font[16*8'h23 + 13] = 8'h00;
        font[16*8'h23 + 14] = 8'h00;
        font[16*8'h23 + 15] = 8'h00;

        // Dollar '$' (0x24)
        font[16*8'h24 +  0] = 8'h10;
        font[16*8'h24 +  1] = 8'h7C;
        font[16*8'h24 +  2] = 8'hD6;
        font[16*8'h24 +  3] = 8'hD0;
        font[16*8'h24 +  4] = 8'hD0;
        font[16*8'h24 +  5] = 8'h7C;
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
        font[16*8'h49 +  8] = 8'h18;
        font[16*8'h49 +  9] = 8'h7E;
        font[16*8'h49 + 10] = 8'h00;
        font[16*8'h49 + 11] = 8'h00;
        font[16*8'h49 + 12] = 8'h00;
        font[16*8'h49 + 13] = 8'h00;
        font[16*8'h49 + 14] = 8'h00;
        font[16*8'h49 + 15] = 8'h00;

        // 'J' (0x4A)
        font[16*8'h4A +  0] = 8'h00;
        font[16*8'h4A +  1] = 8'h1E;
        font[16*8'h4A +  2] = 8'h0C;
        font[16*8'h4A +  3] = 8'h0C;
        font[16*8'h4A +  4] = 8'h0C;
        font[16*8'h4A +  5] = 8'h0C;
        font[16*8'h4A +  6] = 8'h0C;
        font[16*8'h4A +  7] = 8'hCC;
        font[16*8'h4A +  8] = 8'hCC;
        font[16*8'h4A +  9] = 8'h78;
        font[16*8'h4A + 10] = 8'h00;
        font[16*8'h4A + 11] = 8'h00;
        font[16*8'h4A + 12] = 8'h00;
        font[16*8'h4A + 13] = 8'h00;
        font[16*8'h4A + 14] = 8'h00;
        font[16*8'h4A + 15] = 8'h00;

        // 'K' (0x4B)
        font[16*8'h4B +  0] = 8'h00;
        font[16*8'h4B +  1] = 8'hE6;
        font[16*8'h4B +  2] = 8'h66;
        font[16*8'h4B +  3] = 8'h6C;
        font[16*8'h4B +  4] = 8'h6C;
        font[16*8'h4B +  5] = 8'h78;
        font[16*8'h4B +  6] = 8'h6C;
        font[16*8'h4B +  7] = 8'h6C;
        font[16*8'h4B +  8] = 8'h66;
        font[16*8'h4B +  9] = 8'hE6;
        font[16*8'h4B + 10] = 8'h00;
        font[16*8'h4B + 11] = 8'h00;
        font[16*8'h4B + 12] = 8'h00;
        font[16*8'h4B + 13] = 8'h00;
        font[16*8'h4B + 14] = 8'h00;
        font[16*8'h4B + 15] = 8'h00;

        // 'L' (0x4C)
        font[16*8'h4C +  0] = 8'h00;
        font[16*8'h4C +  1] = 8'hF0;
        font[16*8'h4C +  2] = 8'h60;
        font[16*8'h4C +  3] = 8'h60;
        font[16*8'h4C +  4] = 8'h60;
        font[16*8'h4C +  5] = 8'h60;
        font[16*8'h4C +  6] = 8'h60;
        font[16*8'h4C +  7] = 8'h62;
        font[16*8'h4C +  8] = 8'h66;
        font[16*8'h4C +  9] = 8'hFE;
        font[16*8'h4C + 10] = 8'h00;
        font[16*8'h4C + 11] = 8'h00;
        font[16*8'h4C + 12] = 8'h00;
        font[16*8'h4C + 13] = 8'h00;
        font[16*8'h4C + 14] = 8'h00;
        font[16*8'h4C + 15] = 8'h00;

        // 'M' (0x4D)
        font[16*8'h4D +  0] = 8'h00;
        font[16*8'h4D +  1] = 8'hC6;
        font[16*8'h4D +  2] = 8'hEE;
        font[16*8'h4D +  3] = 8'hFE;
        font[16*8'h4D +  4] = 8'hFE;
        font[16*8'h4D +  5] = 8'hD6;
        font[16*8'h4D +  6] = 8'hC6;
        font[16*8'h4D +  7] = 8'hC6;
        font[16*8'h4D +  8] = 8'hC6;
        font[16*8'h4D +  9] = 8'hC6;
        font[16*8'h4D + 10] = 8'h00;
        font[16*8'h4D + 11] = 8'h00;
        font[16*8'h4D + 12] = 8'h00;
        font[16*8'h4D + 13] = 8'h00;
        font[16*8'h4D + 14] = 8'h00;
        font[16*8'h4D + 15] = 8'h00;

        // 'N' (0x4E)
        font[16*8'h4E +  0] = 8'h00;
        font[16*8'h4E +  1] = 8'hC6;
        font[16*8'h4E +  2] = 8'hE6;
        font[16*8'h4E +  3] = 8'hF6;
        font[16*8'h4E +  4] = 8'hFE;
        font[16*8'h4E +  5] = 8'hDE;
        font[16*8'h4E +  6] = 8'hCE;
        font[16*8'h4E +  7] = 8'hC6;
        font[16*8'h4E +  8] = 8'hC6;
        font[16*8'h4E +  9] = 8'hC6;
        font[16*8'h4E + 10] = 8'h00;
        font[16*8'h4E + 11] = 8'h00;
        font[16*8'h4E + 12] = 8'h00;
        font[16*8'h4E + 13] = 8'h00;
        font[16*8'h4E + 14] = 8'h00;
        font[16*8'h4E + 15] = 8'h00;

        // 'O' (0x4F)
        font[16*8'h4F +  0] = 8'h00;
        font[16*8'h4F +  1] = 8'h7C;
        font[16*8'h4F +  2] = 8'hC6;
        font[16*8'h4F +  3] = 8'hC6;
        font[16*8'h4F +  4] = 8'hC6;
        font[16*8'h4F +  5] = 8'hC6;
        font[16*8'h4F +  6] = 8'hC6;
        font[16*8'h4F +  7] = 8'hC6;
        font[16*8'h4F +  8] = 8'hC6;
        font[16*8'h4F +  9] = 8'h7C;
        font[16*8'h4F + 10] = 8'h00;
        font[16*8'h4F + 11] = 8'h00;
        font[16*8'h4F + 12] = 8'h00;
        font[16*8'h4F + 13] = 8'h00;
        font[16*8'h4F + 14] = 8'h00;
        font[16*8'h4F + 15] = 8'h00;

        // 'P' (0x50)
        font[16*8'h50 +  0] = 8'h00;
        font[16*8'h50 +  1] = 8'hFC;
        font[16*8'h50 +  2] = 8'h66;
        font[16*8'h50 +  3] = 8'h66;
        font[16*8'h50 +  4] = 8'h66;
        font[16*8'h50 +  5] = 8'h7C;
        font[16*8'h50 +  6] = 8'h60;
        font[16*8'h50 +  7] = 8'h60;
        font[16*8'h50 +  8] = 8'h60;
        font[16*8'h50 +  9] = 8'hF0;
        font[16*8'h50 + 10] = 8'h00;
        font[16*8'h50 + 11] = 8'h00;
        font[16*8'h50 + 12] = 8'h00;
        font[16*8'h50 + 13] = 8'h00;
        font[16*8'h50 + 14] = 8'h00;
        font[16*8'h50 + 15] = 8'h00;

        // 'Q' (0x51)
        font[16*8'h51 +  0] = 8'h00;
        font[16*8'h51 +  1] = 8'h7C;
        font[16*8'h51 +  2] = 8'hC6;
        font[16*8'h51 +  3] = 8'hC6;
        font[16*8'h51 +  4] = 8'hC6;
        font[16*8'h51 +  5] = 8'hC6;
        font[16*8'h51 +  6] = 8'hC6;
        font[16*8'h51 +  7] = 8'hD6;
        font[16*8'h51 +  8] = 8'hDE;
        font[16*8'h51 +  9] = 8'h7C;
        font[16*8'h51 + 10] = 8'h0C;
        font[16*8'h51 + 11] = 8'h0E;
        font[16*8'h51 + 12] = 8'h00;
        font[16*8'h51 + 13] = 8'h00;
        font[16*8'h51 + 14] = 8'h00;
        font[16*8'h51 + 15] = 8'h00;

        // 'R' (0x52)
        font[16*8'h52 +  0] = 8'h00;
        font[16*8'h52 +  1] = 8'hFC;
        font[16*8'h52 +  2] = 8'h66;
        font[16*8'h52 +  3] = 8'h66;
        font[16*8'h52 +  4] = 8'h66;
        font[16*8'h52 +  5] = 8'h7C;
        font[16*8'h52 +  6] = 8'h6C;
        font[16*8'h52 +  7] = 8'h66;
        font[16*8'h52 +  8] = 8'h66;
        font[16*8'h52 +  9] = 8'hE6;
        font[16*8'h52 + 10] = 8'h00;
        font[16*8'h52 + 11] = 8'h00;
        font[16*8'h52 + 12] = 8'h00;
        font[16*8'h52 + 13] = 8'h00;
        font[16*8'h52 + 14] = 8'h00;
        font[16*8'h52 + 15] = 8'h00;

        // 'S' (0x53)
        font[16*8'h53 +  0] = 8'h00;
        font[16*8'h53 +  1] = 8'h7C;
        font[16*8'h53 +  2] = 8'hC6;
        font[16*8'h53 +  3] = 8'hC6;
        font[16*8'h53 +  4] = 8'h60;
        font[16*8'h53 +  5] = 8'h38;
        font[16*8'h53 +  6] = 8'h0C;
        font[16*8'h53 +  7] = 8'h06;
        font[16*8'h53 +  8] = 8'hC6;
        font[16*8'h53 +  9] = 8'h7C;
        font[16*8'h53 + 10] = 8'h00;
        font[16*8'h53 + 11] = 8'h00;
        font[16*8'h53 + 12] = 8'h00;
        font[16*8'h53 + 13] = 8'h00;
        font[16*8'h53 + 14] = 8'h00;
        font[16*8'h53 + 15] = 8'h00;

        // 'T' (0x54)
        font[16*8'h54 +  0] = 8'h00;
        font[16*8'h54 +  1] = 8'h7E;
        font[16*8'h54 +  2] = 8'h5A;
        font[16*8'h54 +  3] = 8'h18;
        font[16*8'h54 +  4] = 8'h18;
        font[16*8'h54 +  5] = 8'h18;
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
        font[16*8'h69 +  8] = 8'h18;
        font[16*8'h69 +  9] = 8'h3C;
        font[16*8'h69 + 10] = 8'h00;
        font[16*8'h69 + 11] = 8'h00;
        font[16*8'h69 + 12] = 8'h00;
        font[16*8'h69 + 13] = 8'h00;
        font[16*8'h69 + 14] = 8'h00;
        font[16*8'h69 + 15] = 8'h00;

        // 'j' (0x6A)
        font[16*8'h6A +  0] = 8'h00;
        font[16*8'h6A +  1] = 8'h06;
        font[16*8'h6A +  2] = 8'h06;
        font[16*8'h6A +  3] = 8'h00;
        font[16*8'h6A +  4] = 8'h0E;
        font[16*8'h6A +  5] = 8'h06;
        font[16*8'h6A +  6] = 8'h06;
        font[16*8'h6A +  7] = 8'h06;
        font[16*8'h6A +  8] = 8'h66;
        font[16*8'h6A +  9] = 8'h3C;
        font[16*8'h6A + 10] = 8'h00;
        font[16*8'h6A + 11] = 8'h00;
        font[16*8'h6A + 12] = 8'h00;
        font[16*8'h6A + 13] = 8'h00;
        font[16*8'h6A + 14] = 8'h00;
        font[16*8'h6A + 15] = 8'h00;

        // 'k' (0x6B)
        font[16*8'h6B +  0] = 8'h00;
        font[16*8'h6B +  1] = 8'hE0;
        font[16*8'h6B +  2] = 8'h60;
        font[16*8'h6B +  3] = 8'h66;
        font[16*8'h6B +  4] = 8'h6C;
        font[16*8'h6B +  5] = 8'h78;
        font[16*8'h6B +  6] = 8'h78;
        font[16*8'h6B +  7] = 8'h6C;
        font[16*8'h6B +  8] = 8'h66;
        font[16*8'h6B +  9] = 8'hE6;
        font[16*8'h6B + 10] = 8'h00;
        font[16*8'h6B + 11] = 8'h00;
        font[16*8'h6B + 12] = 8'h00;
        font[16*8'h6B + 13] = 8'h00;
        font[16*8'h6B + 14] = 8'h00;
        font[16*8'h6B + 15] = 8'h00;

        // 'l' (0x6C)
        font[16*8'h6C +  0] = 8'h00;
        font[16*8'h6C +  1] = 8'h38;
        font[16*8'h6C +  2] = 8'h18;
        font[16*8'h6C +  3] = 8'h18;
        font[16*8'h6C +  4] = 8'h18;
        font[16*8'h6C +  5] = 8'h18;
        font[16*8'h6C +  6] = 8'h18;
        font[16*8'h6C +  7] = 8'h18;
        font[16*8'h6C +  8] = 8'h18;
        font[16*8'h6C +  9] = 8'h3C;
        font[16*8'h6C + 10] = 8'h00;
        font[16*8'h6C + 11] = 8'h00;
        font[16*8'h6C + 12] = 8'h00;
        font[16*8'h6C + 13] = 8'h00;
        font[16*8'h6C + 14] = 8'h00;
        font[16*8'h6C + 15] = 8'h00;

        // 'm' (0x6D)
        font[16*8'h6D +  0] = 8'h00;
        font[16*8'h6D +  1] = 8'h00;
        font[16*8'h6D +  2] = 8'h00;
        font[16*8'h6D +  3] = 8'hEC;
        font[16*8'h6D +  4] = 8'hFE;
        font[16*8'h6D +  5] = 8'hD6;
        font[16*8'h6D +  6] = 8'hD6;
        font[16*8'h6D +  7] = 8'hD6;
        font[16*8'h6D +  8] = 8'hD6;
        font[16*8'h6D +  9] = 8'hC6;
        font[16*8'h6D + 10] = 8'h00;
        font[16*8'h6D + 11] = 8'h00;
        font[16*8'h6D + 12] = 8'h00;
        font[16*8'h6D + 13] = 8'h00;
        font[16*8'h6D + 14] = 8'h00;
        font[16*8'h6D + 15] = 8'h00;

        // 'n' (0x6E)
        font[16*8'h6E +  0] = 8'h00;
        font[16*8'h6E +  1] = 8'h00;
        font[16*8'h6E +  2] = 8'h00;
        font[16*8'h6E +  3] = 8'hDC;
        font[16*8'h6E +  4] = 8'h66;
        font[16*8'h6E +  5] = 8'h66;
        font[16*8'h6E +  6] = 8'h66;
        font[16*8'h6E +  7] = 8'h66;
        font[16*8'h6E +  8] = 8'h66;
        font[16*8'h6E +  9] = 8'h66;
        font[16*8'h6E + 10] = 8'h00;
        font[16*8'h6E + 11] = 8'h00;
        font[16*8'h6E + 12] = 8'h00;
        font[16*8'h6E + 13] = 8'h00;
        font[16*8'h6E + 14] = 8'h00;
        font[16*8'h6E + 15] = 8'h00;

        // 'o' (0x6F)
        font[16*8'h6F +  0] = 8'h00;
        font[16*8'h6F +  1] = 8'h00;
        font[16*8'h6F +  2] = 8'h00;
        font[16*8'h6F +  3] = 8'h7C;
        font[16*8'h6F +  4] = 8'hC6;
        font[16*8'h6F +  5] = 8'hC6;
        font[16*8'h6F +  6] = 8'hC6;
        font[16*8'h6F +  7] = 8'hC6;
        font[16*8'h6F +  8] = 8'hC6;
        font[16*8'h6F +  9] = 8'h7C;
        font[16*8'h6F + 10] = 8'h00;
        font[16*8'h6F + 11] = 8'h00;
        font[16*8'h6F + 12] = 8'h00;
        font[16*8'h6F + 13] = 8'h00;
        font[16*8'h6F + 14] = 8'h00;
        font[16*8'h6F + 15] = 8'h00;

        // 'p' (0x70)
        font[16*8'h70 +  0] = 8'h00;
        font[16*8'h70 +  1] = 8'h00;
        font[16*8'h70 +  2] = 8'h00;
        font[16*8'h70 +  3] = 8'hDC;
        font[16*8'h70 +  4] = 8'h66;
        font[16*8'h70 +  5] = 8'h66;
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
        font[16*8'h7D +  8] = 8'h18;
        font[16*8'h7D +  9] = 8'h70;
        font[16*8'h7D + 10] = 8'h00;
        font[16*8'h7D + 11] = 8'h00;
        font[16*8'h7D + 12] = 8'h00;
        font[16*8'h7D + 13] = 8'h00;
        font[16*8'h7D + 14] = 8'h00;
        font[16*8'h7D + 15] = 8'h00;

        // '~' (0x7E)
        font[16*8'h7E +  0] = 8'h00;
        font[16*8'h7E +  1] = 8'h76;
        font[16*8'h7E +  2] = 8'hDC;
        font[16*8'h7E +  3] = 8'h00;
        font[16*8'h7E +  4] = 8'h00;
        font[16*8'h7E +  5] = 8'h00;
        font[16*8'h7E +  6] = 8'h00;
        font[16*8'h7E +  7] = 8'h00;
        font[16*8'h7E +  8] = 8'h00;
        font[16*8'h7E +  9] = 8'h00;
        font[16*8'h7E + 10] = 8'h00;
        font[16*8'h7E + 11] = 8'h00;
        font[16*8'h7E + 12] = 8'h00;
        font[16*8'h7E + 13] = 8'h00;
        font[16*8'h7E + 14] = 8'h00;
        font[16*8'h7E + 15] = 8'h00;
    end

    // BRAM read: registered output
    always @(posedge clk) begin
        data <= font[addr];
    end

endmodule
