TurBoss/z80neo/firmware/z80neo/src/display.c

// display.c
// Z80NEO Firmware — Display & UI module
// TurBoss 2026

#include <stdarg.h>
#include <stdbool.h>
#include <stdint.h>
#include <stdio.h>
#include <string.h>

#include <hardware/adc.h>
#include <hardware/gpio.h>
#include <pico/stdlib.h>
#include <pico/time.h>

#include "ff.h"
#include "tf_card.h"

#include "cpm_disk.h"
#include "display.h"
#include "logo.h"
#include "memory.h"
#include "screensaver.h"
#include "z80bus_pio.h"
#include "z80neo_logo.h"

// ===========================================================================
// Globals
// ===========================================================================

struct render_area frame_area = {.start_col = 0,
								 .end_col = SSD1306_WIDTH - 1,
								 .start_page = 0,
								 .end_page = SSD1306_NUM_PAGES - 1};

// Display buffer (also used as SD work buffer for DMA alignment)
uint32_t buf32[(BUF_SIZE + 3) / 4];
uint8_t *buf = (uint8_t *)buf32;

// Aliases — all point to buf32
uint8_t *disp_buf_0 = (uint8_t *)buf32;
uint8_t *disp_buf_1 = (uint8_t *)buf32;
uint8_t *disp_buf_2 = (uint8_t *)buf32;
uint8_t *disp_buf_3 = (uint8_t *)buf32;
uint8_t *disp_buf_4 = (uint8_t *)buf32;
uint8_t *disp_buf_5 = (uint8_t *)buf32;
uint8_t *disp_buf_6 = (uint8_t *)buf32;
uint8_t *disp_buf_7 = (uint8_t *)buf32;

// Text lines (screen buffer)
char line1[TEXT_BUFFER_SIZE];
char line2[TEXT_BUFFER_SIZE];
char line3[TEXT_BUFFER_SIZE];
char line4[TEXT_BUFFER_SIZE];
char line5[TEXT_BUFFER_SIZE];
char line6[TEXT_BUFFER_SIZE];
char line7[TEXT_BUFFER_SIZE];
char line8[TEXT_BUFFER_SIZE];

char *screen[LINES] = {line1, line2, line3, line4, line5, line6, line7, line8};

char text_buffer[TEXT_BUFFER_SIZE];
char serial_text_buffer[TEXT_BUFFER_SIZE];

char line_buffer0[24];
char line_buffer1[24];
char line_buffer2[24];
char line_buffer3[24];
char line_buffer4[24];
char line_buffer5[24];
char line_buffer6[24];
char line_buffer7[24];

char tbmon_text_buffer[8][32];

const char *hexStringChar[] = {"0", "1", "2", "3", "4", "5", "6", "7",
							   "8", "9", "a", "b", "C", "d", "E", "F"};

char *load_chars = "|/-\\-|-//";
uint8_t load_char_index = 0;

display_line file;

volatile bool tbmon = false;
volatile bool tbmon_loaded = false;
uint16_t tbmon_idx = 0;

volatile bool confirmed = false;

// ===========================================================================
// Static display buffer used during main() init
// ===========================================================================
static uint8_t display_buf[SSD1306_BUF_LEN];

// ===========================================================================
// Helpers
// ===========================================================================

int center_string(char *string) {
	int n = strlen(string);
	int l = 8 - (n / 2);
	return l < 0 ? 0 : l;
}

// ===========================================================================
// Screen clearing
// ===========================================================================

void clear_screen(void) {
	memset(buf, 0, SSD1306_BUF_LEN);
	render(buf, &frame_area);

	memset(line1, 0, TEXT_BUFFER_SIZE);
	memset(line2, 0, TEXT_BUFFER_SIZE);
	memset(line3, 0, TEXT_BUFFER_SIZE);
	memset(line4, 0, TEXT_BUFFER_SIZE);
	memset(line5, 0, TEXT_BUFFER_SIZE);
	memset(line6, 0, TEXT_BUFFER_SIZE);
	memset(line7, 0, TEXT_BUFFER_SIZE);
	memset(line8, 0, TEXT_BUFFER_SIZE);
}

void clear_screen0(void) {
	memset(buf, 0, SSD1306_BUF_LEN);

	memset(line1, 0, TEXT_BUFFER_SIZE);
	memset(line2, 0, TEXT_BUFFER_SIZE);
	memset(line3, 0, TEXT_BUFFER_SIZE);
	memset(line4, 0, TEXT_BUFFER_SIZE);
	memset(line5, 0, TEXT_BUFFER_SIZE);
	memset(line6, 0, TEXT_BUFFER_SIZE);
	memset(line7, 0, TEXT_BUFFER_SIZE);
	memset(line8, 0, TEXT_BUFFER_SIZE);
}

void clear_line0(int line) {
	if (line < 0 || line >= LINES)
		return;
	memset(screen[line], 0, TEXT_BUFFER_SIZE);
	strcpy(screen[line], "                ");
	WriteString(buf, 0, line * 8, screen[line]);
}

void clear_line(int line) {
	clear_line0(line);
	render(buf, &frame_area);
}

// ===========================================================================
// String output
// ===========================================================================

void print_string0(int x, int y, char *text, ...) {
	va_list args;
	va_start(args, text);
	vsnprintf(text_buffer, TEXT_BUFFER_SIZE, text, args);
	strcpy(screen[y], text_buffer);
	WriteString(buf, x * 8, y * 8, text_buffer);
	va_end(args);
}

void print_string(int x, int y, char *text, ...) {
	va_list args;
	va_start(args, text);
	vsnprintf(text_buffer, TEXT_BUFFER_SIZE, text, args);
	strcpy(screen[y], text_buffer);
	WriteString(buf, x * 8, y * 8, text_buffer);
	render(buf, &frame_area);
}

void print_line(int x, char *text, ...) {
	va_list args;
	va_start(args, text);
	vsnprintf(text_buffer, TEXT_BUFFER_SIZE, text, args);
	char *screen0 = screen[0];
	for (int i = 0; i < 7; i++) {
		screen[i] = screen[i + 1];
		WriteString(buf, x * 8, i * 8, screen[i]);
	}
	screen[7] = screen0;
	strcpy(screen[7], text_buffer);
	WriteString(buf, x * 8, 7 * 8, text_buffer);
	render(buf, &frame_area);
	va_end(args);
}

void print_line0(int x, char *text, ...) {
	va_list args;
	va_start(args, text);
	vsnprintf(text_buffer, TEXT_BUFFER_SIZE, text, args);
	char *screen0 = screen[0];
	for (int i = 0; i < 3; i++) {
		screen[i] = screen[i + 1];
		WriteString(buf, x * 8, i * 8, screen[i]);
	}
	screen[3] = screen0;
	strcpy(screen[3], text_buffer);
	WriteString(buf, x * 8, 3 * 8, text_buffer);
	va_end(args);
}

// ===========================================================================
// Character output
// ===========================================================================

void print_char0(int x, int y, char c) {
	text_buffer[0] = c;
	text_buffer[1] = 0;
	WriteString(buf, x * 8, y * 8, text_buffer);
}

void print_char(int x, int y, char c) {
	text_buffer[0] = c;
	text_buffer[1] = 0;
	WriteString(buf, x * 8, y * 8, text_buffer);
	render(buf, &frame_area);
}

// ===========================================================================
// Pixel plotting
// ===========================================================================

void disp_plot0(int x, int y) { SetPixel(buf, x, y, true); }

void plot_pixel(int x, int y) {
	SetPixel(buf, x, y, true);
	render(buf, &frame_area);
}

void unplot_pixel(int x, int y) {
	SetPixel(buf, x, y, false);
	render(buf, &frame_area);
}

// ===========================================================================
// Line drawing
// ===========================================================================

void disp_line0(int x1, int y1, int x2, int y2) {
	DrawLine(buf, x1, y1, x2, y2, true);
}

void disp_line(int x1, int y1, int x2, int y2) {
	DrawLine(buf, x1, y1, x2, y2, true);
	render(buf, &frame_area);
}

void unplot_line(int x1, int y1, int x2, int y2) {
	DrawLine(buf, x1, y1, x2, y2, false);
	render(buf, &frame_area);
}

void render_display(void) { render(buf, &frame_area); }

// ===========================================================================
// RAM viewer
// ===========================================================================

void display_ram_viewer(void) {
	for (int line = 0; line < LINES; line++) {
		int offset = tbmon_idx + (line * BYTES_PER_ROW);
		char byte_data[8];

		sprintf(tbmon_text_buffer[line], "%04x ", offset & 0xFFFF);

		for (int col = 0; col < BYTES_PER_ROW; col++) {
			uint8_t v = ram[cur_bank][(offset + col) & 0x3FFF];
			if (col < 3)
				sprintf(byte_data, "%02x:", v);
			else
				sprintf(byte_data, "%02x", v);
			strcat(tbmon_text_buffer[line], byte_data);
		}

		print_string(0, line, tbmon_text_buffer[line]);
	}
}

// ===========================================================================
// Button I/O
// ===========================================================================

button_state read_button_state(void) {
	adc_select_input(0);
	uint16_t adc = adc_read();

	if (adc <= UP_ADC) {
		return UP;
	} else if (adc <= DOWN_ADC) {
		return DOWN;
	} else if (adc <= BACK_ADC) {
		return BACK;
	} else if (adc <= OK_ADC) {
		return OK;
	} else if (adc <= CANCEL_ADC) {
		return CANCEL;
	} else {
		return NONE;
	}
}

// Non-blocking debounce for the main-loop trigger.  The ADC is sampled at most
// once every BUTTON_DEBOUNCE_US and a state is accepted only after
// BUTTON_DEBOUNCE_SAMPLES identical reads, so a single noisy sample (or
// contact bounce) cannot reset the Z80.  Nothing sleeps; the caller polls.
#define BUTTON_DEBOUNCE_US 1000
#define BUTTON_DEBOUNCE_SAMPLES 4

button_state read_button_state_debounced(void) {
	static button_state stable = NONE;
	static button_state candidate = NONE;
	static uint8_t count = 0;
	static uint64_t next = 0;

	uint64_t now = time_us_64();
	if (now < next) {
		return stable;
	}
	next = now + BUTTON_DEBOUNCE_US;

	button_state s = read_button_state();
	if (s == candidate) {
		if (count < BUTTON_DEBOUNCE_SAMPLES)
			count++;
	} else {
		candidate = s;
		count = 1;
	}
	if (count >= BUTTON_DEBOUNCE_SAMPLES) {
		stable = candidate;
	}
	return stable;
}

bool wait_for_button_release(void) {
	uint64_t last = time_us_64();
	while (read_button_state() != NONE) {
	}
	return (time_us_64() - last > LONG_BUTTON_DELAY);
}

void wait_for_button(void) {
	while (read_button_state() == NONE) {
	}
	wait_for_button_release();
	return;
}

bool wait_for_yes_no_button(void) {
	button_state button;
	while (true) {
		button = read_button_state();
		if (button == OK) {
			wait_for_button_release();
			return true;
		} else if (button == CANCEL || button == CANCEL2) {
			wait_for_button_release();
			return false;
		}
	}
}

// ===========================================================================
// Menu / pages (core 1)
//
// The Z80 keeps running while the menu is open, so the pages read live globals.
// Destructive actions (bank select/clear, file load) pause it first via the
// disabled/confirmed handshake so core 0 stops the bus and clock.
// ===========================================================================

typedef enum {
	PAGE_SYSTEM = 0,
	PAGE_CPU,
	PAGE_BUS,
	PAGE_MEM,
	PAGE_DISK,
	PAGE_DIAG,
	PAGE_SCREENSAVER,
	PAGE_FILES
} page_id_t;

static const char *const menu_labels[] = {
	"System",	   "CPU / Clock", "Bus / Timing", "Memory & Banks",
	"Disk Drives", "Diagnostics", "Screensaver",  "Files / Load"};
#define MENU_ITEMS ((int)(sizeof(menu_labels) / sizeof(menu_labels[0])))
#define MENU_VISIBLE 6
#define UI_TICK 8

static bool ui_home = true; // idle: show the text logo, not the menu
static uint64_t ui_idle_since = 0;
static int ui_menu_sel = 0, ui_menu_top = 0;
static int ui_page = -1, ui_page_sel = 0;
static bool ui_arm_clear = false;
static button_state ui_last_btn = NONE;
static int ui_file_idx = 1, ui_file_count = 0;
static int ui_ss_sel = 0; // screensaver page selection (0..3)

// Idle timeout choices offered by the Screensaver page, in seconds.
static const uint32_t ui_ss_idle_choices[] = {10, 30, 60, 120, 300};
#define UI_SS_IDLE_N                                                           \
	((int)(sizeof(ui_ss_idle_choices) / sizeof(ui_ss_idle_choices[0])))

static void ui_z80_pause(void) {
	reset_hold();
	confirmed = false;
	disabled = true;
	while (!confirmed)
		tight_loop_contents();
}

static void ui_z80_resume(void) {
	disabled = false;
	reset_release();
}

static void ui_render(char lines[LINES][24]) {
	clear_screen0();
	for (int i = 0; i < LINES; i++)
		if (lines[i][0])
			WriteString(buf, 0, i * 8, lines[i]);
	render(buf, &frame_area);
}

static void ui_draw_logo(void) {
	// Full-screen 128x64 bitmap generated by tools/img_to_array.py
	// (source: tools/z80neo.svg), installed as include/z80neo.h.
	render(z80neo, &frame_area);
}

static void ui_draw_menu(void) {
	char l[LINES][24];
	memset(l, 0, sizeof(l));
	snprintf(l[0], 24,
			 "== Z80 %lukHz ==", (unsigned long)(CPU_SPEED / 1000.0f));
	for (int i = 0; i < MENU_VISIBLE; i++) {
		int idx = ui_menu_top + i;
		if (idx >= MENU_ITEMS)
			break;
		snprintf(l[i + 1], 24, "%c%-15.15s", idx == ui_menu_sel ? '>' : ' ',
				 menu_labels[idx]);
	}
	snprintf(l[7], 24, "OK:open  C:close");
	ui_render(l);
}

static void ui_draw_system(void) {
	char l[LINES][24];
	memset(l, 0, sizeof(l));
	snprintf(l[0], 24, "== SYSTEM ==");
	snprintf(l[1], 24, "%s", VERSION);
	snprintf(l[2], 24, "%.16s", MACHINE);
	snprintf(l[3], 24, "BANKS %dx16K", MAX_BANKS);
	snprintf(l[4], 24, "PSRAM %s", psram_base ? "OK" : "none");
	snprintf(l[5], 24, "CLK %lu kHz", (unsigned long)(CPU_SPEED / 1000.0f));
	snprintf(l[6], 24, "DUTY %lu%%", (unsigned long)(CPU_DUTY * 100.0f + 0.5f));
	snprintf(l[7], 24, "OK/BACK: menu");
	ui_render(l);
}
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
