TurBoss/z80neo/(commit log)

2025-11-07 add PDF schematics
2025-11-07 add schematic image and more references
2025-11-07 added missing lines to iorq and wr in the schematic and SD ini file
2025-11-14 update pcb files
    [main.kicad_pcb, main.kicad_sch]
2025-11-15 pcb routing
    [main.kicad_pcb, main.kicad_sch]
2025-11-15 update readme schematic
2025-11-17 change freq to 200Hz
2025-11-17 fix osc to 8 Khz
    [main.c]
2025-11-19 re think memory and device io
2025-11-20 disable overclock, back to 150Mhz and add i2c display to schematic
    [main.kicad_pcb, main.kicad_sch]
2025-11-22 use tht components
    [main.kicad_pcb, main.kicad_sch]
2026-09-16 fix cpu speed to 128 Khz
    [display.c, main.c, memory.c, z80bus_pio.c, z80bus_pio.h]
2026-09-18 add VDP
    [main.kicad_sch]
2026-10-10 fix SPI link
2026-10-10 fix spi VDP
